nguyennhutkhanhtom/NPU/docs/demos/README.md

# Demos

> **Category: GUIDE.** Choose the execution flow before running a model.

| Demo | Purpose |
|---|---|
| [NanoFable language](language.md) | Run pretrained autonomous inference on `llm_soc` |
| [Supported model/exporter](candidates.md) | Check compatibility and requirements for changing checkpoints |
| [Legacy demos](legacy/README.md) | MNIST, CPU/RTL hybrid NanoFable and old model surveys |

Current verification and application status: [optimization status](../verification/optimization_status.md).
