nguyennhutkhanhtom/NPU/tools/README.md

# Công cụ hỗ trợ

> **Category: GUIDE.**

[Project](../README.md) → **Tools**

| Thư mục | Công việc |
|---|---|
| [timing](timing/README.md) | Chạy Quartus, extract reports và ghi timing evidence |
| [optimization](optimization/README.md) | Archive checkpoint và tính tỷ lệ thay đổi RTL |
| [llm](llm/README.md) | Generate/kiểm tra bảng số học của graph |
| [docs](docs/README.md) | Công cụ source guide và render tài liệu/sơ đồ |

Sơ đồ đang giữ snapshot cũ; đợt cập nhật docs 06/10/2026 chưa chạy render hoặc
sửa diagram definitions. Chỉ chạy công cụ tương ứng với phần cần thay đổi và
giữ evidence/archive trước khi tạo output mới.
