nguyennhutkhanhtom/NPU/docs/reviews/README.md

# Implementation reviews

> **Category: GUIDE.** Reviews explain decisions at a named source snapshot; they do not define live status.

| Review | Scope |
|---|---|
| [P0/P1 implementation evidence](../../review/architecture_optimization_20261007.md) | Latest implemented greedy bypass and bounded linear-row overlap rationale |
| [Architecture proposal review](../../review/architecture_review.md) | Assessment and measurement order for the preceding proposal |
| [Throughput review v3](rtl_change_review_v3.md) | Earlier cache/streaming/engine implementation rationale, snapshot 2026-10-06 |
| [Archived reviews](../history/reviews/rtl_change_review_v2.md) | Earlier timing, integration and design reviews; see [history index](../history/README.md) |

Current verification and implementation status: [optimization status](../verification/optimization_status.md).
