nguyennhutkhanhtom/NPU/docs/design/exact_throughput_optimization.md

# Tối ưu throughput và quyền dùng tài nguyên

> **Category: GUIDE.**

[Tài liệu](../README.md) → [Thiết kế](README.md) → **Throughput**

Tối ưu giữ geometry cố định của graph: bốn layer, 128 channel, bốn head,
FFN 384 channel, vocabulary 4.096 và context 128. Mục tiêu là giảm compute clocks
và SRAM transactions, đồng thời giữ rounding, saturation, faults, sampling ties
và thứ tự cập nhật PRNG. Số liệu đo nằm trong [review version 3](../reviews/rtl_change_review_v3.md).

## Quyền sở hữu tài nguyên

| Owner | Công việc | Tài nguyên dùng chung |
|---|---|---|
| llm_soc | Graph, metadata, operand cache, scaling, vector writes, probability/V pass và sampling | SRAM, SIMD và các scalar units |
| llm_linear_engine | Một ternary row, hai-word prefetch credit, reserved-code fault và response drain | Parameter SRAM, immutable operand cache |
| llm_head_engine | Stream 4.096 row: scale word mỗi tám row, bốn int8 chunk mỗi row, tối đa tám read outstanding, S39 row accumulation theo thứ tự | Parameter SRAM, cached final hidden vector và SIMD |
| llm_attention_engine | Q/K causal requests, score scaling, score storage và maximum | KV SRAM, held query và SIMD |
| llm_attention_normalize | Exact RNE divide, sign restoration và S24 clamp theo batch | Lane 0 dùng chung divider RMSNorm; ba divider riêng bổ sung |
| ternary_dot32 | S25 terms và balanced S30 reduction pipeline | Logic add/subtract riêng |

Mỗi pass phải drain các response trước khi parent chuyển resource ownership.
Parameter SRAM chỉ có một owner phát request tại một thời điểm. Các test kiểm
tra ownership và giới hạn hai-word prefetch của linear engine.

## Operand cache, scales và packed stores

Một register cache **12 × 768 bit = 9.216 payload bits** dùng chung cho linear
và head. Q, O, Gate và Down preload input; Q/K/V và Gate/Up chỉ reuse khi source,
geometry và family khớp. Producer writes, reset, launch, faults hoặc head entry
làm mất hiệu lực linear cache. Head nạp lại bốn row của final-normalized vector
ở mỗi pass; không thêm cache riêng cho head.

Head engine giữ hai scale slot, mỗi slot là tám coefficient U24 của một nhóm
tám vocabulary row; bit [31:24] của mỗi slot 32 bit bị bỏ qua. Scale word của
nhóm G chỉ ghi đè slot của nhóm G-2 sau 32 weight response của nhóm G-1, khi
nhóm G-2 đã retire. Vocabulary order và PRNG updates giữ nguyên. RoPE K
reuse bảng của Q khi position tag còn hợp lệ, đồng thời vẫn đọc K vector riêng.
Nạp norm gains vào table storage dùng chung làm mất validity của RoPE tag.

Linear pack 32 scalar outputs vào write_vector_q. Lane 31 được capture trước
transaction full-mask kế tiếp; completion chờ write drain. Reset probes phủ
prefetch, in-flight dot, coefficient processing và lane cuối trước flush.

## SIMD streaming và replication

llm_math giữ mode legacy mặc định. Với STREAMING=1, `start && in_ready` có thể
accept mỗi clock khi pipeline còn các transaction trước. Tính từ acceptance E0,
product_valid xuất ở E3, sum_valid ở E8 và legacy done ở E9. Các response có stage
riêng; consumer phải dùng đúng valid channel. Reset hủy validity và deassert ready.

Bốn sigmoid lane xử lý batch bốn phần tử với interpolation/RNE giữ nguyên.
Normalizer capture quotient và rounding metadata, rồi tách round, phục hồi dấu
và clamp thành các stage register.

ATTN_DIV_LANES và SIGMOID_LANES là elaboration parameters, hỗ trợ các lũy thừa
hai chia hết 32: 1, 2, 4, 8, 16 hoặc 32. Geometry mặc định và phạm vi áp dụng của
evidence được ghi tại [kiến trúc](full_rtl_language.md) và [trạng thái](../verification/optimization_status.md).

## Transaction geometry

Việc reuse operand/scale có giới hạn và ghi vector dạng packed giúp giảm số
SRAM transaction. Số liệu đo trước/sau thuộc [throughput review ngày 2026-10-06](../reviews/rtl_change_review_v3.md);
số liệu hiện tại và phạm vi áp dụng được ghi trong [trạng thái kiểm chứng](../verification/optimization_status.md).

## Source và kiểm chứng

isqrt_u64 và sram_word_tile đã tách thành file dùng chung. Full-top Quartus file
list không compile norm, banked_word_ram hoặc sram_256_wrapper legacy. Những
module này vẫn được giữ cho caller và regression riêng. Operator IDs cần cho
fixture cũ được giữ; chúng không thêm một graph operation mới.

Regression giữ reference S128 độc lập, kiểm tra sustained/sparse streaming,
S24_MIN, reserved ternary code và normalization exact. Không dùng approximate
reciprocal trong đường normalize này. [Verification status](../verification/optimization_status.md)
ghi bằng chứng áp dụng cho workspace; application cần all-seven PASS và full-top
timing khớp source/config trước pretrained execution.

## Cache reuse và ownership

Sơ đồ này tóm tắt các điều kiện điều khiển của parent; nó không bổ sung cache
module instance. Các predicate trong source vẫn là nguồn chuẩn.

```mermaid
%%{init: {
  "theme": "base",
  "themeVariables": {
    "background": "#ffffff",
    "primaryTextColor": "#111111",
    "secondaryTextColor": "#111111",
    "tertiaryTextColor": "#111111",
    "lineColor": "#444444",
    "clusterBkg": "#ffffff",
    "clusterBorder": "#aaaaaa",
    "edgeLabelBackground": "#ffffff",
    "fontSize": "17px"
  },
  "flowchart": {
    "curve": "linear",
    "nodeSpacing": 30,
    "rankSpacing": 40,
    "htmlLabels": true,
    "useMaxWidth": true
  }
}}%%
flowchart TB
 S["Parent input selection<br/>Source, shape and<br/>family"] --> T{"Matching valid tag?"}
 T -->|"Q/K/V or Gate/Up reuse"| C["Operand cache<br/>12 × 768 bit"]
 T -->|"miss or head entry"| L["Vector SRAM refill"]
 L --> C
 C --> A["Linear / head<br/>operands Parent-owned routing"]
 P["Producer / reset /<br/>launch / fault Invalidate<br/>per parent predicates"] -.-> T
classDef control fill:#f8cecc,stroke:#b85450,color:#111111;
classDef interface fill:#fff2cc,stroke:#d6b656,color:#111111;
classDef buffer fill:#f5f5f5,stroke:#666666,color:#111111;
classDef compute fill:#b1ddf0,stroke:#10739e,color:#111111;
classDef output fill:#dae8fc,stroke:#6c8ebf,color:#111111;
classDef platform fill:#e1d5e7,stroke:#9673a6,color:#111111;
class T control;
class S,C,A,P buffer;
class L platform;
```

```mermaid
%%{init: {
  "theme": "base",
  "themeVariables": {
    "background": "#ffffff",
    "primaryTextColor": "#111111",
    "secondaryTextColor": "#111111",
    "tertiaryTextColor": "#111111",
    "lineColor": "#444444",
    "clusterBkg": "#ffffff",
    "clusterBorder": "#aaaaaa",
    "edgeLabelBackground": "#ffffff",
    "fontSize": "17px"
  },
  "flowchart": {
    "curve": "linear",
    "nodeSpacing": 30,
    "rankSpacing": 40,
    "htmlLabels": true,
    "useMaxWidth": true
  }
}}%%
flowchart LR
 R["RoPE position tag"] --> K{"Matching valid table?"}
 K -->|"yes"| U["Reuse cos /<br/>sin Read K<br/>vector separately"]
 K -->|"no"| F["Fetch table<br/>Update tag"]
 G["Norm gain load<br/>Shared payload invalidation"] -.-> K
classDef control fill:#f8cecc,stroke:#b85450,color:#111111;
classDef interface fill:#fff2cc,stroke:#d6b656,color:#111111;
classDef buffer fill:#f5f5f5,stroke:#666666,color:#111111;
classDef compute fill:#b1ddf0,stroke:#10739e,color:#111111;
classDef output fill:#dae8fc,stroke:#6c8ebf,color:#111111;
classDef platform fill:#e1d5e7,stroke:#9673a6,color:#111111;
class K control;
class R,U,F,G buffer;
```
