nguyennhutkhanhtom/NPU/docs/design/host_interface.md

# Host interface của llm_soc

> **Category: GUIDE.**

[Tài liệu](../README.md) → [Thiết kế](README.md) → **Host interface**

Host và DUT dùng cùng `clk`. Mọi địa chỉ bên dưới là byte address, căn chỉnh
4 byte. Core matmulfree có host contract riêng trong [interface legacy](<legacy/interfaces.md>).

## Ports

| Signal | Vai trò |
|---|---|
| clk, rst_n | Clock và reset active-low |
| host_en, host_we | Có request; 1=write, 0=read |
| host_addr, host_wdata | Address và write data, mỗi tín hiệu 32 bit |
| host_ready, host_rdata | ACK và read data 32 bit |
| running, ready | Graph đang chạy hoặc idle, xuất qua register |
| error, overflow_out | Lỗi graph/format/bounds; cờ một kết quả linear bị kẹp S24 |
| pc_debug, instr_debug | Position 9 bit và phase/debug word 13 bit |

## Memory map

| Window/register | Address | Nội dung |
|---|---|---|
| Parameters | 0x00000000…0x000BFFFC | 768 KiB, 32-bit host lanes của word 256 bit |
| Prompt IDs | 0x00100000…0x001001FC | 128 slot; lấy 12 bit thấp của word |
| Output IDs | 0x00200000…0x002001FC | Continuation IDs; đọc khi graph idle |
| Status | 0x00400000 | Running, ready, error, overflow và output count |
| Prompt count | 0x00400004 | Số prompt token, ghi 8 bit thấp; mặc định 0 |
| Maximum new tokens | 0x00400008 | Số token mới tối đa; mặc định 96 |
| Start | 0x0040000C | Ghi bit 0=1 khi idle |
| Temperature | 0x00400010 | U8/F8, mặc định 166; 0 chọn greedy |
| Random seed | 0x00400014 | Xorshift32 seed; 0 được đổi thành 1 |
| Minimum new tokens | 0x00400018 | Mask EOS trước count này; mặc định 64 |

Status dùng bits 0=running, 1=ready, 2=error, 3=overflow và bits 11:4=output
count. Overflow chỉ bật khi một hàng kết quả linear (Q/K/V/O/Gate/Up/Down)
bị kẹp về S24, và giữ tới lần START hợp lệ kế tiếp. Các phép kẹp khác
(embedding, RMSNorm, RoPE, cộng dư, SiLU, GMUL, attention, logit) không bật cờ;
với checkpoint pretrained hiện có, không phép kẹp activation nào bão hòa
([census](../../tests/full_rtl/evidence/clamp_census_20261024/results.json)). Chỉ đọc các register/window mà RTL hỗ trợ; không giả định config writes
có register readback. Graph sở hữu KV và vector workspace.

## Một transaction

```mermaid
%%{init: {
  "theme": "base",
  "themeVariables": {
    "background": "#ffffff",
    "primaryTextColor": "#111111",
    "secondaryTextColor": "#111111",
    "tertiaryTextColor": "#111111",
    "lineColor": "#444444",
    "clusterBkg": "#ffffff",
    "clusterBorder": "#aaaaaa",
    "edgeLabelBackground": "#ffffff",
    "fontSize": "17px"
  },
  "flowchart": {
    "curve": "linear",
    "nodeSpacing": 30,
    "rankSpacing": 40,
    "htmlLabels": true,
    "useMaxWidth": true
  }
}}%%
flowchart TB
 I["H_IDLE: host_en captures<br/>address / data<br/>/ write flag"] --> E["H_EXEC: decode registered request"]
 E -->|"Parameter read while idle"| R["H_READ: issue host_read_req"]
 R --> W["H_WAIT: wait for p_host_valid"]
 E -->|"Parameter write while idle"| W
 E -->|"Register / status / output / ignored access"| D["H_DONE: hold host_ready<br/>until host_en drops"]
 W -->|"Read payload captured or write committed"| D
 D -->|"host_en=0 for at least one clock"| I
 C["host_en=0 cancels frontend response<br/>Accepted writes can still commit"] -.-> I
 X["rst_n assertion cancels<br/>uncommitted queue entries<br/>SRAM contents retained"] -.-> I
classDef control fill:#f8cecc,stroke:#b85450,color:#111111;
classDef interface fill:#fff2cc,stroke:#d6b656,color:#111111;
classDef buffer fill:#f5f5f5,stroke:#666666,color:#111111;
classDef compute fill:#b1ddf0,stroke:#10739e,color:#111111;
classDef output fill:#dae8fc,stroke:#6c8ebf,color:#111111;
classDef platform fill:#e1d5e7,stroke:#9673a6,color:#111111;
class C interface;
class E,R,W,D buffer;
class I compute;
class X platform;
```

1. Đặt address, write flag và data; assert `host_en`.
2. Giữ các signal request ổn định cho đến khi `host_ready=1`.
3. Với read, lấy `host_rdata` tại ACK.
4. Deassert `host_en` ít nhất một clock rồi bắt đầu request kế tiếp.

Parameters được đọc đồng bộ qua adapter. Write ACK chờ leaf commit; thời gian
ACK có thể khác nhau giữa memory access và register access. Write trong lúc graph
đang chạy không sửa parameters/config/prompt. Status vẫn dùng để poll tiến độ.
Sau một lỗi (fault), status giữ running=1 cho đến khi phần việc engine/memory
đang dở đã drain xong; START ghi trong lúc đó bị bỏ qua như mọi write khi đang chạy.

Deassert enable trước execution edge sẽ hủy write. Sau khi write được accept,
deassert enable sẽ hủy response nhưng write vẫn có thể commit. Reset hủy queue
entry chưa commit và giữ các word đã commit; host không được giả định rollback.

## Trình tự chạy graph

1. Reset và chờ internal reset release sau hai rising edge.
2. Khi idle, ghi đầy đủ parameter image qua parameter window.
3. Ghi prompt IDs theo thứ tự, bắt đầu tại 0x00100000.
4. Ghi prompt count, maximum new tokens, temperature, seed và minimum new tokens.
5. Ghi START; polling status đến khi graph idle, kiểm tra error và output count.
6. Đọc continuation IDs từ output window rồi decode bằng tokenizer đã pin.

Điều kiện launch: prompt count >0, maximum new tokens >0 và tổng của chúng ≤128.
Exporter giới hạn new tokens trong 1…127 và kiểm tra tokenized prompt trước khi
mô phỏng. Chọn `MinNew ≤ NewTokens` trong demo để cấu hình EOS dễ hiểu.

Testbench application đã thực hiện host sequence này. Dùng
[hướng dẫn NanoFable](../demos/language.md) để chạy từ PowerShell thay vì tự ghi bus.
[Protocol và cancellation evidence](../verification/optimization_status.md) ghi
các trường hợp handshake, reset và ACK đã kiểm chứng.
