nguyennhutkhanhtom/NPU/docs/demos/legacy/README.md

# Demo và khảo sát legacy

> **Category: LEGACY.**

[Tài liệu](../../README.md) → [Demo](../README.md) → **Legacy**

| Tài liệu | Phạm vi |
|---|---|
| [NanoFable hybrid](nanofable_hybrid.md) | CPU generation, 168 lượt linear RTL và 33.792 output S32 |
| [Binary-MNIST160](<mnist.md>) | Checkpoint classifier và core matmulfree trên 10 ảnh mẫu |
| [Khảo sát model 32 PE](model_candidates.md) | Các model/layout cho parameter 32 KiB và workspace 8 KiB |

Các kết quả ở đây giữ giá trị trong phạm vi của từng báo cáo. Hướng dẫn chạy
full graph hiện tại ở [NanoFable trên llm_soc](../language.md); trạng thái
application ở [verification status](../../verification/optimization_status.md).
