nguyennhutkhanhtom/NPU/docs/source_guide/blocks/llm_gumbel_lut.svh.md

# llm_gumbel_lut.svh

> **Role:** Combinational S24/F16 samples of -ln(-ln((index+0.5)/256)).
> **Scope:** CURRENT. **Category:** GUIDE.
> **Source:** [llm_gumbel_lut.svh](<../../../Verilog Source code/llm_gumbel_lut.svh>).

## Important contracts

`llm_gumbel_sample` takes an 8-bit index covering 0…255. The parent owns PRNG progression, temperature scaling and score saturation. The explicit case table has no register or memory latency. Numeric entries are generated by [table generator](../../../tools/llm/generate_tables.py); the source table owns exact values.

## Related docs

[Numeric contracts](../../design/full_rtl_language.md#hợp-đồng-số-học) · [RTL math tests](../../../tests/full_rtl/tb_math.sv) · [Source index](README.md)
