nguyennhutkhanhtom/NPU/docs/source_guide/full_graph.md

# Các khối RTL của full graph

> **Category: GUIDE.**

[Tài liệu](../README.md) → [Source guide](README.md) → **Full graph**

## Top và cấu hình

File chính là [llm_soc.sv](<../../Verilog Source code/llm_soc.sv>).
Nó quản lý host, graph và tài nguyên dùng chung. [matmulfree.sv](<../../Verilog Source code/matmulfree.sv>)
là top legacy, dùng ISA/descriptor và memory map khác.

`llm_soc` có 32 SIMD lane, mỗi lane tạo một term của dot product; reduction tạo
một output. Số lane không đồng nghĩa với 32 output hoàn chỉnh cùng lúc. Bốn
sigmoid lane và bốn divider lane mặc định tăng throughput cho các batch tương ứng.

## Sơ đồ tài nguyên và đường dữ liệu

Đây là functional overview. Các đường qua **Parent request and operand muxes**
được thực hiện trong llm_soc, không phải dây nối trực tiếp giữa hai engine. Xem
[hierarchy và port-map manifest](../diagrams/README.md) để tra instance, generate
scope và kết nối chính xác.

```mermaid
%%{init: {
  "theme": "base",
  "themeVariables": {
    "background": "#ffffff",
    "primaryTextColor": "#111111",
    "secondaryTextColor": "#111111",
    "tertiaryTextColor": "#111111",
    "lineColor": "#444444",
    "clusterBkg": "#ffffff",
    "clusterBorder": "#aaaaaa",
    "edgeLabelBackground": "#ffffff",
    "fontSize": "17px"
  },
  "flowchart": {
    "curve": "linear",
    "nodeSpacing": 30,
    "rankSpacing": 40,
    "htmlLabels": true,
    "useMaxWidth": true
  }
}}%%
flowchart TB
 H["Host interface<br/>32-bit request / response"] <--> F["Host frontend<br/>Prompt, config and output IDs"]
 subgraph MEMORY["Shared storage"]
  P["u_parameters<br/>24576 × 256 bit"]
  V["u_vectors<br/>96 × 768 bit"]
  K["u_cache<br/>4096 × 768 bit"]
 end
 F <--> P
 R["Parent resource muxes<br/>Compute requests / payloads"] <--> P
 R <--> V
 R <--> K
 C["Graph / operator control<br/>Phase and routing"] -.-> R
 C -.-> F
classDef control fill:#f8cecc,stroke:#b85450,color:#111111;
classDef interface fill:#fff2cc,stroke:#d6b656,color:#111111;
classDef buffer fill:#f5f5f5,stroke:#666666,color:#111111;
classDef compute fill:#b1ddf0,stroke:#10739e,color:#111111;
classDef output fill:#dae8fc,stroke:#6c8ebf,color:#111111;
classDef platform fill:#e1d5e7,stroke:#9673a6,color:#111111;
class C control;
class H interface;
class R buffer;
class F output;
class P,V,K platform;
style MEMORY fill:#ffffff,stroke:#aaaaaa,color:#111111;
```

```mermaid
%%{init: {
  "theme": "base",
  "themeVariables": {
    "background": "#ffffff",
    "primaryTextColor": "#111111",
    "secondaryTextColor": "#111111",
    "tertiaryTextColor": "#111111",
    "lineColor": "#444444",
    "clusterBkg": "#ffffff",
    "clusterBorder": "#aaaaaa",
    "edgeLabelBackground": "#ffffff",
    "fontSize": "17px"
  },
  "flowchart": {
    "curve": "linear",
    "nodeSpacing": 30,
    "rankSpacing": 40,
    "htmlLabels": true,
    "useMaxWidth": true
  }
}}%%
flowchart TB
 C["Parent phase control<br/>llm_soc"] -.-> L & H & A
 subgraph ENGINES["Compute engines"]
 L["u_linear_engine<br/>Ternary rows"]
 H["u_head_engine<br/>Ordered int8 chunks"]
 A["u_attention_engine<br/>Causal QK scores"]
 end
 R["Parent muxes<br/>Requests / operands / returns"] <--> L & H & A
 R --> M["u_math<br/>32 streaming SIMD lanes"]
 M -->|"sum / valid"| R
 style ENGINES fill:#ffffff,stroke:#aaaaaa,color:#111111;
classDef control fill:#f8cecc,stroke:#b85450,color:#111111;
classDef interface fill:#fff2cc,stroke:#d6b656,color:#111111;
classDef buffer fill:#f5f5f5,stroke:#666666,color:#111111;
classDef compute fill:#b1ddf0,stroke:#10739e,color:#111111;
classDef output fill:#dae8fc,stroke:#6c8ebf,color:#111111;
classDef platform fill:#e1d5e7,stroke:#9673a6,color:#111111;
class C control;
class L,H,A,M compute;
class R interface;
```

```mermaid
%%{init: {
  "theme": "base",
  "themeVariables": {
    "background": "#ffffff",
    "primaryTextColor": "#111111",
    "secondaryTextColor": "#111111",
    "tertiaryTextColor": "#111111",
    "lineColor": "#444444",
    "clusterBkg": "#ffffff",
    "clusterBorder": "#aaaaaa",
    "edgeLabelBackground": "#ffffff",
    "fontSize": "17px"
  },
  "flowchart": {
    "curve": "linear",
    "nodeSpacing": 30,
    "rankSpacing": 40,
    "htmlLabels": true,
    "useMaxWidth": true
  }
}}%%
flowchart TB
 C["Parent arithmetic routing<br/>RMSNorm / attention / SiLU"] -.-> D & Q & N
 D["u_div<br/>Shared divider"] -->|"quotient + remainder"| N["u_attention_normalize<br/>Shared lane 0 + private lanes"]
 Q["Root / sigmoid resources"] --> C
 N --> C
classDef control fill:#f8cecc,stroke:#b85450,color:#111111;
classDef interface fill:#fff2cc,stroke:#d6b656,color:#111111;
classDef buffer fill:#f5f5f5,stroke:#666666,color:#111111;
classDef compute fill:#b1ddf0,stroke:#10739e,color:#111111;
classDef output fill:#dae8fc,stroke:#6c8ebf,color:#111111;
classDef platform fill:#e1d5e7,stroke:#9673a6,color:#111111;
class C interface;
class D,Q platform;
class N output;
```

## Đọc source theo luồng

| Thứ tự | Source | Nên tìm gì? |
|---|---|---|
| 1 | [llm_pkg](<../../Verilog Source code/llm_pkg.sv>) | Constants, layout và helper nhỏ |
| 2 | [llm_soc](<../../Verilog Source code/llm_soc.sv>) | Host FSM, graph FSM, operator states và register owners |
| 3 | [linear engine](<../../Verilog Source code/llm_linear_engine.sv>) | Prefetch, operand chunk, reduction và format fault |
| 4 | [attention engine](<../../Verilog Source code/llm_attention_engine.sv>) | Causal requests, Q/K score pipeline và score memory |
| 5 | [attention normalizer](<../../Verilog Source code/llm_attention_normalize.sv>) | Quotient/remainder, RNE, dấu và clamp |
| 6 | [head engine](<../../Verilog Source code/llm_head_engine.sv>) | Vocabulary row, ordered chunks và shared SIMD |
| 7 | [memory adapters](<../../Verilog Source code/llm_parameter_ram.sv>) | Accepted requests, response-valid, write commitment |

## Control và các engine

| Module | Input/output hoặc state cần theo dõi |
|---|---|
| llm_soc | graph, op, layer_q, position_q, generated_q, error, overflow_out và host FSM |
| llm_linear_engine | Hai-word FIFO, credits, chunk index, operand capture, accumulator, fault và response drain |
| llm_head_engine | Stream 4.096 vocabulary row: scale word mỗi tám row, bốn weight chunk mỗi row, tối đa tám read outstanding, hai scale slot và S39 accumulator theo thứ tự |
| llm_attention_engine | position bound, KV request tags, sum_valid, score pipeline và maximum |
| llm_attention_normalize | Batch/lane progress, shared divider lane zero, rounding metadata và result-valid |

Parent có thể overlap một next linear row với scalar/store tail hiện tại; completion
được giữ lại để bảo đảm thứ tự tiêu thụ.

Graph chọn một phase tại một thời điểm. Engine có thể giữ nhiều request hoặc
arithmetic transaction trong pipeline của phase đó. Parent chỉ đổi quyền dùng
tài nguyên sau khi các response của pass đã được drain.

`llm_soc` giữ một operand cache 12 × 768 bit. Q/K/V và Gate/Up chỉ reuse khi
source, shape và family hợp lệ; head reload input khi vào pass. Head engine giữ
scale word của hai nhóm tám vocabulary row; parent giữ table RoPE có position tag. Các điều kiện
invalidate ở [hợp đồng cache](../design/exact_throughput_optimization.md).

## Số học chung

| Module | Hợp đồng |
|---|---|
| [ternary_dot32](<../../Verilog Source code/ternary_dot32.sv>) | Mã 00/01/11 → zero/positive/negative; term mở rộng S25, reduction S30; code 10 gây fault |
| [llm_math](<../../Verilog Source code/llm_math.sv>) | STREAMING=1 accept theo start && in_ready; product E3, sum E8, done E9 tính từ E0 |
| [logic_mul](<../../Verilog Source code/logic_mul.sv>) | Cây nhân bằng bit products và cộng; không runtime multiplication operator |
| [div](<../../Verilog Source code/div.sv>) | Unsigned divide bằng shift/subtract; caller xử lý rounding/sign |
| [isqrt_u64](<../../Verilog Source code/isqrt_u64.sv>) | Integer square root dùng chung; file đã tách khỏi norm legacy |
| [sigmoid](<../../Verilog Source code/sigmoid.sv>) | ROM/interpolation; các lane dùng cùng quy tắc số học |

Tín hiệu product_valid, sum_valid và done thuộc các stage khác nhau. Không dùng
product của một transaction với sum của transaction khác. Reset hủy validity;
payload register không reset vẫn phải được bảo vệ bởi protocol hợp lệ.

## Memory và reset

| Module | Vai trò |
|---|---|
| [llm_parameter_ram](<../../Verilog Source code/llm_parameter_ram.sv>) | Parameter window, host lane selection và ACK sau commit |
| [llm_bank_ram](<../../Verilog Source code/llm_bank_ram.sv>) | Các bank S24 của vectors/KV; lane mask và wr_busy |
| [pipelined_word_ram](<../../Verilog Source code/pipelined_word_ram.sv>) | Tiled request/response adapter |
| [quartus_word_ram](<../../Verilog Source code/quartus_word_ram.sv>) | Technology leaf duy nhất chứa altsyncram |
| [sram_word_tile](<../../Verilog Source code/sram_word_tile.sv>) | Portable behavioral leaf |
| [reset_release](<../../Verilog Source code/reset_release.sv>) | Assert reset ngay; nhả sau hai rising edge |

[Host interface](../design/host_interface.md) ghi cách software điều khiển top.
[SRAM binding](../design/asic_memory_binding.md) ghi latency/collision/reset cần
bảo toàn khi thay technology leaf.

## Chú giải và sơ đồ đã lưu

Mỗi module có một tài liệu trong [modules/](README.md#danh-mục-file-rtl);
[mục lục source guide](README.md) liệt kê đủ 41 file RTL/LUT. [Hierarchy legacy](<legacy/README.md>)
lưu sơ đồ matmulfree.
