nguyennhutkhanhtom/NPU/docs/source_guide/modules/npu_pkg.md

# `npu_pkg` — Package hằng số, kiểu và hàm làm tròn / bão hòa dùng chung

| Mục | Giá trị |
|---|---|
| File | `npu_pkg.sv` |
| Loại | `package` (không phải phần cứng độc lập) |
| Nhóm | Hạ tầng — dùng chung |
| Được dùng bởi | **`llm_soc`**: `llm_soc`, `llm_attention_engine`, `sigmoid` (dùng `rne_shift64`, `sat_s16`, `sat_s32`). **Legacy**: `matmulfree`, `descriptor_file`, `rowwise_dispatch`, `rowwise_op`, `norm_dispatch`, `norm`, `ternary_mul`, `postscale`, `mul` |

## 0. Kiến thức cần biết trước

**Package.** Trong SystemVerilog, `package` là nơi gom các hằng số, kiểu dữ liệu và hàm dùng chung, tương tự file header trong C. Module dùng nó bằng `import npu_pkg::*;`.

**Hàm trong phần cứng.** Một `function` trong RTL không phải chương trình con được "gọi" lúc chạy. Mỗi chỗ dùng hàm sinh ra **một bản mạch riêng**. Vì vậy các hàm ở đây đều nhỏ và thuần tổ hợp.

**`struct packed`.** Một nhóm trường bit ghép liền nhau thành một vector bit dài. Ví dụ `ws_desc_t` dài đúng 32 bit, nên host ghi được bằng một word.

Các khái niệm bão hòa, RNE, scale dạng m × 2⁻ʳ được giải thích ở tài liệu kiến thức nền, mục 3.

Các khái niệm chung (thanh ghi, cạnh clock, pipeline, valid, fixed-point, RNE…) được giải thích trong [../00_kien_thuc_nen.md](../00_kien_thuc_nen.md).

## 1. Tổng quan

`npu_pkg` gom các quy ước của NPU `matmulfree`: kích thước bộ nhớ, độ rộng dữ liệu, định dạng tensor, cấu trúc descriptor. Ngoài ra nó chứa các hàm làm tròn/bão hòa (`rne_shift64`, `sat_s16`, `sat_s32`) mà **cả `llm_soc`** cũng import và dùng (RNE ở mọi bước `*_ROUND`, `sat_s32` cho logit, `sat_s16` cho đầu vào sigmoid). Các hàm này là **hàm thuần tổ hợp**: mỗi chỗ gọi sinh ra một khối logic riêng.

## 2. Hằng số

| Hằng | Giá trị | Ý nghĩa |
|---|---|---|
| `SRAM_W` | 256 | Bit / hàng SRAM |
| `PARAM_AW`, `PARAM_DEPTH` | 10, 1024 | SRAM tham số 32 KiB (`mem_mapping`) |
| `WORK_AW`, `WORK_DEPTH` | 8, 256 | Workspace 8 KiB (`register`) |
| `ACT_W` | 8 | Activation S8 |
| `STATE_W` | 16 | Trạng thái S16 |
| `WEIGHT_W` | 2 | Trọng số ternary 2 bit |
| `DOT_LANES` | 32 | Số làn tích vô hướng |
| `VEC_LANES` | 2 | Số làn vector |
| `ACC_W` | 18 | Bộ tích lũy |
| `K_MAX` | 512 | Độ dài tối đa của vector/K |
| `M_W`, `SHIFT_W` | 24, 6 | Mantissa và số bit dịch của scale |

## 3. Kiểu

```mermaid
flowchart LR
    classDef ctrl fill:#f8cecc,stroke:#b85450,color:#000
    classDef param fill:#f5f5f5,stroke:#666666,color:#333
    WS["ws_desc_t (32b)<br/>base_word 8 · length 10 · fmt 2<br/>frac_bits 5 · reserved 7"]:::ctrl
    MD["mat_desc_t (96b)<br/>weight_base 10 · bias_base 10 · k_len 10 · n_rows 10<br/>scale_m 24 · scale_r 6 · output_s32 1 · reserved 25"]:::param
    FMT["tensor_fmt_t<br/>S8=0 · S16=1 · U16=2 · S32=3"]:::ctrl
    FMT --> WS
```

Chi tiết từng trường xem [descriptor_file.md](descriptor_file.md).

## 4. Hàm

| Hàm | Chức năng |
|---|---|
| `sat_s16(x)` / `sat_s32(x)` | Bão hòa số S64 về S16 / S32 |
| `rne_shift64(x, shift)` | Dịch phải số học, làm tròn tới chẵn gần nhất (RNE), shift 0..63 |
| `rne_shift42(x, shift)` | RNE cho tích S42 của postscale; `shift ≥ 42` trả 0 |
| `scale_shift64(x, shift)` | `shift ≥ 0`: `rne_shift64`; `shift < 0`: dịch trái |
| `ws_words(d)` | Số word 256 bit mà tensor chiếm: S8 `ceil(n/32)`, S16/U16 `ceil(n/16)`, S32 `ceil(n/8)` |
| `ws_valid(d)` | `0 < length ≤ 512`, `frac_bits ≤ 24`, `base_word + ws_words ≤ 256` |
| `ranges_overlap(a, an, b, bn)` | Hai vùng `[a, a+an)` và `[b, b+bn)` có giao nhau không |

### 4.1 Làm tròn RNE không cần phủ định

`rne_shift64` không tính giá trị tuyệt đối. Nó dùng tính chất của dịch số học:

1. `q = x >>> shift` cho `floor(x / 2^shift)`.
2. Các bit bị bỏ được dồn lên MSB: `discarded = x << (64 − shift)`. Biểu thức dịch dùng 7 bit, nên khi `shift = 0` lượng dịch là 64 và mọi bit bị đẩy ra; không có bit nào bị bỏ.
3. `guard = discarded[63]` (bit nửa), `sticky = |discarded[62:0]`.
4. `inc = guard && (sticky || q[0])`, và kết quả là `q + inc`.

Vì `floor` đúng cho cả số âm, phần dư luôn dương, nên một quy tắc duy nhất làm tròn đúng cả hai dấu, kể cả trường hợp hòa: chọn số chẵn.
