nguyennhutkhanhtom/NPU/docs/source_guide/blocks/banked_word_ram.sv.md

# banked_word_ram.sv

> **Category: GUIDE. Scope: LEGACY.** RTL is authoritative; diagrams use the [shared visual style](../../diagrams/diagram_style.md).
[Documentation](../../README.md) → [Source guide](../full_graph.md) → [RTL index](README.md)

**Source:** [banked_word_ram.sv](<../../../Verilog%20Source%20code/banked_word_ram.sv>).

## At a glance

| Item | Description |
|---|---|
| Responsibility | Legacy three-pass RMS normalization and quantization. Two shared structural multipliers, one divider and the separately defined isqrt_u64 serve the explicit pass controller. Workspace scratch and final quantized values are packed in 256-bit words. |

## Sơ đồ kiến trúc

```mermaid
%%{init: {
  "theme": "base",
  "themeVariables": {
    "background": "#ffffff",
    "primaryTextColor": "#111111",
    "secondaryTextColor": "#111111",
    "tertiaryTextColor": "#111111",
    "lineColor": "#444444",
    "clusterBkg": "#ffffff",
    "clusterBorder": "#aaaaaa",
    "edgeLabelBackground": "#ffffff",
    "fontSize": "17px"
  },
  "flowchart": {
    "curve": "linear",
    "nodeSpacing": 30,
    "rankSpacing": 40,
    "htmlLabels": true,
    "useMaxWidth": true
  }
}}%%
flowchart TB
    REQ["Read and write requests"] --> TILE["1024-word leaf SRAM"]
    REQ --> TAG["Registered tile selection"]
    TILE --> MUX["One-hot data reduction"]
    TAG --> MUX
    MUX --> OUT["Read data after one edge"]
classDef control fill:#f8cecc,stroke:#b85450,color:#111111;
classDef interface fill:#fff2cc,stroke:#d6b656,color:#111111;
classDef buffer fill:#f5f5f5,stroke:#666666,color:#111111;
classDef compute fill:#b1ddf0,stroke:#10739e,color:#111111;
classDef output fill:#dae8fc,stroke:#6c8ebf,color:#111111;
classDef platform fill:#e1d5e7,stroke:#9673a6,color:#111111;
class REQ interface;
class TILE platform;
class TAG,OUT buffer;
class MUX compute;
```
