nguyennhutkhanhtom/NPU/docs/source_guide/blocks/isqrt_u64.sv.md

# isqrt_u64.sv

> **Category: GUIDE. Scope: CURRENT (may also have legacy callers).** RTL is authoritative; diagrams use the [shared visual style](../../diagrams/diagram_style.md).
[Documentation](../../README.md) → [Source guide](../full_graph.md) → [RTL index](README.md)

**Source:** [isqrt_u64.sv](<../../../Verilog%20Source%20code/isqrt_u64.sv>).

## At a glance

| Item | Description |
|---|---|
| Responsibility | Unsigned floor square root with 32 radix-four iterations. Append two radicand bits per step; one U35 subtractor supplies the trial remainder and borrow decision. Root and remainder feedback are explicit registers. start is accepted only when idle; busy/done frame the result. |

## Sơ đồ kiến trúc

```mermaid
%%{init: {
  "theme": "base",
  "themeVariables": {
    "background": "#ffffff",
    "primaryTextColor": "#111111",
    "secondaryTextColor": "#111111",
    "tertiaryTextColor": "#111111",
    "lineColor": "#444444",
    "clusterBkg": "#ffffff",
    "clusterBorder": "#aaaaaa",
    "edgeLabelBackground": "#ffffff",
    "fontSize": "17px"
  },
  "flowchart": {
    "curve": "linear",
    "nodeSpacing": 30,
    "rankSpacing": 40,
    "htmlLabels": true,
    "useMaxWidth": true
  }
}}%%
flowchart TB
 I["start / U64 radicand"] --> R["Radicand work register<br/>Shift left by two per step"]
 R --> A["Append next two bits<br/>U34 remainder_shift"]
 M["U34 remainder register"] --> A
 Q["U32 root register"] --> T["Trial: root shifted left two OR 1"]
 A --> S["U35 subtractor<br/>Borrow selects acceptance"]
 T --> S
 S --> M
 S --> Q
 C["Controller / 32-step counter"] -.-> R
 C -.-> Q
 C -.-> M
 Q --> O["root U32 / busy / done"]
classDef control fill:#f8cecc,stroke:#b85450,color:#111111;
classDef interface fill:#fff2cc,stroke:#d6b656,color:#111111;
classDef buffer fill:#f5f5f5,stroke:#666666,color:#111111;
classDef compute fill:#b1ddf0,stroke:#10739e,color:#111111;
classDef output fill:#dae8fc,stroke:#6c8ebf,color:#111111;
classDef platform fill:#e1d5e7,stroke:#9673a6,color:#111111;
class C control;
class I,R,M,Q,O buffer;
class A,T,S compute;
```
