nguyennhutkhanhtom/NPU/docs/source_guide/blocks/llm_parameter_ram.sv.md

# llm_parameter_ram.sv — Parameter SRAM và host commit

> **Category: GUIDE. Scope: CURRENT (may also have legacy callers).** RTL is authoritative; diagrams use the [shared visual style](../../diagrams/diagram_style.md).
[Tài liệu](../../README.md) → [Source guide](../README.md) → [Mục lục](README.md)

**Source:** [llm_parameter_ram.sv](<../../../Verilog%20Source%20code/llm_parameter_ram.sv>).

## At a glance

| Item | Description |
|---|---|
| Responsibility | USE_QUARTUS_MEMORY chọn FPGA IP hoặc model ASIC qua word adapter. Compute read bốn cạnh khi DEPTH≤4096, năm cạnh ở cấu hình24576. Host read thêm một cạnh chọn lane trước frontend ACK. Write ACK chỉ sau leaf commit. Valid/tag pipeline loại response host đã hủy hoặc khác địa chỉ; reset giữ SRAM nhưng hủy queue. |

## Sơ đồ kiến trúc

```mermaid
%%{init: {
  "theme": "base",
  "themeVariables": {
    "background": "#ffffff",
    "primaryTextColor": "#111111",
    "secondaryTextColor": "#111111",
    "tertiaryTextColor": "#111111",
    "lineColor": "#444444",
    "clusterBkg": "#ffffff",
    "clusterBorder": "#aaaaaa",
    "edgeLabelBackground": "#ffffff",
    "fontSize": "17px"
  },
  "flowchart": {
    "curve": "linear",
    "nodeSpacing": 30,
    "rankSpacing": 40,
    "htmlLabels": true,
    "useMaxWidth": true
  }
}}%%
flowchart TB
    HOST["Host active address<br/>and explicit requests"] --> BANK["Eight local lane requests"]
    CORE["Compute row request"] --> BANK
    BANK --> SRAM["Technology-selected word banks"]
    SRAM --> ROW["256-bit row after five edges"]
    ROW --> LANE["Registered host lane selection"]
    TAG["Address owner and<br/>cancellation tags"] --> VALID["Compute and host validity"]
    SRAM --> COMMIT["Write commit acknowledgement"]
classDef control fill:#f8cecc,stroke:#b85450,color:#111111;
classDef interface fill:#fff2cc,stroke:#d6b656,color:#111111;
classDef buffer fill:#f5f5f5,stroke:#666666,color:#111111;
classDef compute fill:#b1ddf0,stroke:#10739e,color:#111111;
classDef output fill:#dae8fc,stroke:#6c8ebf,color:#111111;
classDef platform fill:#e1d5e7,stroke:#9673a6,color:#111111;
class HOST,BANK,CORE,LANE,VALID interface;
class SRAM platform;
class ROW,TAG,COMMIT buffer;
```

## Important state / datapath groups

### [Dòng 1–29: Interface and ownership](<../../../Verilog%20Source%20code/llm_parameter_ram.sv#L1>)

Compute và host truy cập độc quyền do top arbitration. Host data/config không phải intermediate graph.

### [Dòng 30–50: Validity and cancellation](<../../../Verilog%20Source%20code/llm_parameter_ram.sv#L30>)

Host response chỉ hợp lệ khi active, loại read/write và địa chỉ vẫn khớp. ACK write theo wr_valid từ leaf, tránh báo xong trước commit.

### [Dòng 51–60: Tags and host payload](<../../../Verilog%20Source%20code/llm_parameter_ram.sv#L51>)

Địa chỉ/lane đi cùng latency suy ra theo DEPTH; output host register tách tile reduction khỏi pin host_rdata.

### [Dòng 61–95: Local lane banks](<../../../Verilog%20Source%20code/llm_parameter_ram.sv#L61>)

Tám lane U32 có request registers riêng, rồi technology adapter. Nội dung và payload không reset; reset chỉ hủy enables/valid.
