nguyennhutkhanhtom/NPU/docs/source_guide/blocks/logic_mul.sv.md

# logic_mul.sv — Portable bit-product compressor tree

> **Category: GUIDE. Scope: CURRENT (may also have legacy callers).** RTL is authoritative; diagrams use the [shared visual style](../../diagrams/diagram_style.md).
[Tài liệu](../../README.md) → [Source guide](../README.md) → [Mục lục](README.md)

**Source:** [logic_mul.sv](<../../../Verilog%20Source%20code/logic_mul.sv>).

## At a glance

| Item | Description |
|---|---|
| Responsibility | Multiplier tổ hợp từ AND/XOR/OR/NOT, dịch hằng và một bộ cộng cuối. Không dùng toán tử nhân/chia hoặc vendor arithmetic IP. A/B có signedness độc lập; OUT_W lấy modulo 2^OUT_W đúng với cắt độ rộng RTL. Callers giữ nguyên register, valid, reset và latency. Bit dấu B mang trọng số âm bằng complemented row cộng correction một; A được sign/zero extend trước khi dịch. |

## Sơ đồ kiến trúc

```mermaid
%%{init: {
  "theme": "base",
  "themeVariables": {
    "background": "#ffffff",
    "primaryTextColor": "#111111",
    "secondaryTextColor": "#111111",
    "tertiaryTextColor": "#111111",
    "lineColor": "#444444",
    "clusterBkg": "#ffffff",
    "clusterBorder": "#aaaaaa",
    "edgeLabelBackground": "#ffffff",
    "fontSize": "17px"
  },
  "flowchart": {
    "curve": "linear",
    "nodeSpacing": 30,
    "rankSpacing": 40,
    "htmlLabels": true,
    "useMaxWidth": true
  }
}}%%
flowchart TB
    A["Sign or zero extend A"] --> BIT["AND with each<br/>B bit and<br/>constant shift"]
    B["B bits and sign bit"] --> BIT
    BIT --> CSA["XOR sum and<br/>majority carry shifted<br/>left"]
    CSA --> TREE["Compress three rows<br/>into two per<br/>level"]
    TREE --> ADD["One final carry-propagate<br/>adder"]
    ADD --> OUT["Low OUT_W product bits"]
classDef control fill:#f8cecc,stroke:#b85450,color:#111111;
classDef interface fill:#fff2cc,stroke:#d6b656,color:#111111;
classDef buffer fill:#f5f5f5,stroke:#666666,color:#111111;
classDef compute fill:#b1ddf0,stroke:#10739e,color:#111111;
classDef output fill:#dae8fc,stroke:#6c8ebf,color:#111111;
classDef platform fill:#e1d5e7,stroke:#9673a6,color:#111111;
class A,B,TREE buffer;
class BIT,CSA,ADD,OUT compute;
```

## Important state / datapath groups

### [Dòng 1–16: Contract and independent signedness](<../../../Verilog%20Source%20code/logic_mul.sv#L1>)

Payload combinational, không reset/handshake riêng. ASIC map cùng module vào standard cells; không cần technology branch.

### [Dòng 17–35: Elaboration geometry](<../../../Verilog%20Source%20code/logic_mul.sv#L17>)

Đếm rows bằng loop hằng, không tạo divider hay counter runtime. Các genvar tạo hierarchy cố định.

### [Dòng 36–72: Partial products and carry-save compression](<../../../Verilog%20Source%20code/logic_mul.sv#L36>)

Unsigned bits góp A dịch trái; signed top bit góp -A dịch trái. Correction bù cộng một; compressor giữ tổng modulo và không có carry chain ngang mỗi level.

### [Dòng 73–74: Final sum](<../../../Verilog%20Source%20code/logic_mul.sv#L73>)

Hai rows còn lại cộng bằng adder thông thường; OUT_W phải dương. Cắt bit cao có chủ ý, caller chịu trách nhiệm saturation/RNE sau product.
