nguyennhutkhanhtom/NPU/docs/source_guide/blocks/quartus_word_ram.sv.md

# quartus_word_ram.sv — FPGA memory technology binding

> **Category: GUIDE. Scope: CURRENT (may also have legacy callers).** RTL is authoritative; diagrams use the [shared visual style](../../diagrams/diagram_style.md).
[Tài liệu](../../README.md) → [Source guide](../README.md) → [Mục lục](README.md)

**Source:** [quartus_word_ram.sv](<../../../Verilog%20Source%20code/quartus_word_ram.sv>).

## At a glance

| Item | Description |
|---|---|
| Responsibility | IP duy nhất của Quartus trong graph là altsyncram M10K. Một read và một write dùng chung clock, raw read một cạnh; OLD_DATA khi cùng địa chỉ. Storage/output không reset, không khởi tạo. ASIC thay module này phía sau adapter, giữ nguyên interface và contract. |

## Sơ đồ kiến trúc

```mermaid
%%{init: {
  "theme": "base",
  "themeVariables": {
    "background": "#ffffff",
    "primaryTextColor": "#111111",
    "secondaryTextColor": "#111111",
    "tertiaryTextColor": "#111111",
    "lineColor": "#444444",
    "clusterBkg": "#ffffff",
    "clusterBorder": "#aaaaaa",
    "edgeLabelBackground": "#ffffff",
    "fontSize": "17px"
  },
  "flowchart": {
    "curve": "linear",
    "nodeSpacing": 30,
    "rankSpacing": 40,
    "htmlLabels": true,
    "useMaxWidth": true
  }
}}%%
flowchart TB
    WR["Write address data enable"] --> IP["altsyncram M10K 1R 1W"]
    RD["Read address enable"] --> IP
    CLK["Common clock"] --> IP
    IP --> Q["Raw read after one edge"]
    CONTRACT["OLD_DATA and no storage reset"] -.-> IP
classDef control fill:#f8cecc,stroke:#b85450,color:#111111;
classDef interface fill:#fff2cc,stroke:#d6b656,color:#111111;
classDef buffer fill:#f5f5f5,stroke:#666666,color:#111111;
classDef compute fill:#b1ddf0,stroke:#10739e,color:#111111;
classDef output fill:#dae8fc,stroke:#6c8ebf,color:#111111;
classDef platform fill:#e1d5e7,stroke:#9673a6,color:#111111;
class WR,RD interface;
class IP platform;
class CLK,CONTRACT control;
class Q buffer;
```

## Important state / datapath groups

### [Dòng 1–15: Technology boundary and ports](<../../../Verilog%20Source%20code/quartus_word_ram.sv#L1>)

Compute/control không instantiate vendor primitive. Client chỉ truy cập qua pipelined_word_ram; địa chỉ phải nhỏ hơn ROWS.

### [Dòng 16–29: Memory configuration](<../../../Verilog%20Source%20code/quartus_word_ram.sv#L16>)

Port A write và port B read. Address/read control B chốt CLOCK0; output unregistered giữ raw latency một cạnh. M10K không dùng DSP hay PLL.

### [Dòng 30–39: Clock and port binding](<../../../Verilog%20Source%20code/quartus_word_ram.sv#L30>)

Clock enables bypass và các cổng không dùng tie constant. Reset/cancellation thuộc adapter ngoài; memory không có reset.
