nguyennhutkhanhtom/NPU/docs/source_guide/blocks/regfile.sv.md

# regfile.sv — Wrapper SRAM 8 KiB

> **Category: GUIDE. Scope: LEGACY.** RTL is authoritative; diagrams use the [shared visual style](../../diagrams/diagram_style.md).
[Tài liệu](../../README.md) → [Hierarchy RTL](<../legacy/README.md>) → [Mục lục từng file](README.md)

**Trạng thái:** Đang dùng.

**Source:** [regfile.sv](<../../../Verilog%20Source%20code/regfile.sv>).

## At a glance

| Item | Description |
|---|---|
| Responsibility | File này giữ interface riêng cho workspace nhưng dùng chung `sram_256_wrapper` với ADDR_W=8. Module có tên `register`; register ở đây là workspace SRAM, không phải một bank 8 thanh ghi vector như tên lịch sử dễ gợi ra. |

## Sơ đồ kiến trúc tổng quan

```mermaid
%%{init: {
  "theme": "base",
  "themeVariables": {
    "background": "#ffffff",
    "primaryTextColor": "#111111",
    "secondaryTextColor": "#111111",
    "tertiaryTextColor": "#111111",
    "lineColor": "#444444",
    "clusterBkg": "#ffffff",
    "clusterBorder": "#aaaaaa",
    "edgeLabelBackground": "#ffffff",
    "fontSize": "17px"
  },
  "flowchart": {
    "curve": "linear",
    "nodeSpacing": 30,
    "rankSpacing": 40,
    "htmlLabels": true,
    "useMaxWidth": true
  }
}}%%
flowchart TB
C["Compute workspace port<br/>Data 256 bit · address 8 bit"]
    H["Host/debug port<br/>Data 32 bit · word-index 11 bit"]
    subgraph WRAP["regfile.sv — module register"]
        subgraph SRAM["sram_256_wrapper · ADDR_W=8"]
            PORT["Masked write / shared synchronous read<br/>Host lane select + host_rvalid"]
            MEM@{ shape: rect, label: "Workspace memory array 256 ×<br/>256 bit 8 bank ×<br/>32 bit 8 KiB" }
            PORT <--> MEM
        end
    end
    C <-->|"Read/write + valid"| PORT
    H <-->|"32-bit lane access + host_rvalid"| PORT
classDef control fill:#f8cecc,stroke:#b85450,color:#111111;
classDef interface fill:#fff2cc,stroke:#d6b656,color:#111111;
classDef buffer fill:#f5f5f5,stroke:#666666,color:#111111;
classDef compute fill:#b1ddf0,stroke:#10739e,color:#111111;
classDef output fill:#dae8fc,stroke:#6c8ebf,color:#111111;
classDef platform fill:#e1d5e7,stroke:#9673a6,color:#111111;
class C,H,PORT interface;
class MEM buffer;
style SRAM fill:#ffffff,stroke:#aaaaaa,color:#111111;
style WRAP fill:#ffffff,stroke:#aaaaaa,color:#111111;
```

## Main flow

Compute đọc/ghi word 256; host chọn một slice32. Wrapper không thêm FSM hay đổi latency. Mỗi port được nối một-một vào implementation chung; xem sram_256_wrapper để hiểu timing và write mask.

1. Đây là wrapper workspace; tên module `register` được giữ để tương thích và không phải register file pipeline của thesis.
2. Compute address 8 bit chọn 256 word 256 bit. Host address thêm ba bit để chọn tám lane 32 bit.
3. Port được nối thẳng vào `sram_256_wrapper`; wrapper không thêm storage, latency hoặc arbitration.
4. Timing read, mask write và quy tắc không overlap do implementation chung quyết định.

**Quy ước RTL.** Wrapper nối `host_rvalid` từ SRAM lên top. Backend nhận read/address từ frontend và trả host_rvalid sau hai cạnh lên. Frontend top chốt request/response, nên host ngoài giữ read/address bốn cạnh lên đến host_ready. Memory có tám bank 32 bit, write-enable riêng từng lane. Wrapper chỉ nối cổng, không thêm register hoặc đổi latency. Simulation và synthesis dùng cùng hợp đồng memory. Xem [implementation và sơ đồ SRAM](sram_256_wrapper.sv.md).

## Important state / datapath groups

### [Dòng 1–21: Hai giao diện](<../../../Verilog%20Source%20code/regfile.sv#L1>)

**Mục đích.** Địa chỉ compute đếm word 256, host đếm word 32. Host address byte đã được top bỏ hai bit alignment.

**Cách phần code hoạt động.** Nhóm này định nghĩa giao diện, độ rộng, kiểu hoặc tín hiệu trung gian. Nó tạo cấu trúc để các nhóm xử lý sau sử dụng, chưa tự biểu diễn một bước runtime riêng.

**Tín hiệu và dữ liệu chính.** `rd_en`: request đọc của compute; `rd_addr`: địa chỉ word cần đọc; `rd_data`: word dữ liệu đọc ra; `rd_valid`: response đọc hợp lệ; `wr_en`: cho phép ghi compute; `wr_addr`: địa chỉ word cần ghi; và 6 tín hiệu phụ khác trong đoạn code.

### [Dòng 22–40: Instance SRAM](<../../../Verilog%20Source%20code/regfile.sv#L22>)

**Mục đích.** Parameter ADDR_W quyết định depth; các named port nối trực tiếp cùng chức năng.

**Cách phần code hoạt động.** Có instance module con; named-port ở nhóm này xác định chính xác đường control/data giữa hai cấp hierarchy.

**Tín hiệu và dữ liệu chính.** `rd_en`: request đọc của compute; `rd_addr`: địa chỉ word cần đọc; `rd_data`: word dữ liệu đọc ra; `rd_valid`: response đọc hợp lệ; `wr_en`: cho phép ghi compute; `wr_addr`: địa chỉ word cần ghi; và 6 tín hiệu phụ khác trong đoạn code.
