nguyennhutkhanhtom/NPU/docs/source_guide/blocks/sigmoid_lut.svh.md

# sigmoid_lut.svh — Sigmoid U16/F15: 1/(1+exp(-index/16+8))

> **Category: GUIDE. Scope: CURRENT (may also have legacy callers).** RTL is authoritative; diagrams use the [shared visual style](../../diagrams/diagram_style.md).
[Source guide](../README.md) · [Mục lục](README.md)

**Source:** [sigmoid_lut.svh](<../../../Verilog%20Source%20code/sigmoid_lut.svh>).

Independent Decimal reference constructs and verifies every sigmoid entry: [reference.py](../../../tests/reference.py).
