nguyennhutkhanhtom/NPU/docs/source_guide/blocks/sram_word_tile.sv.md

# sram_word_tile.sv

> **Category: GUIDE. Scope: CURRENT (may also have legacy callers).** RTL is authoritative; diagrams use the [shared visual style](../../diagrams/diagram_style.md).
[Documentation](../../README.md) → [Source guide](../full_graph.md) → [RTL index](README.md)

**Source:** [sram_word_tile.sv](<../../../Verilog%20Source%20code/sram_word_tile.sv>).

## At a glance

| Item | Description |
|---|---|
| Responsibility | Replaceable portable SRAM behavior leaf with one synchronous read and one write. Nonblocking assignments preserve old data for same-edge same-address read/write. Storage and read payload have no reset or initialization. |

## Sơ đồ kiến trúc

```mermaid
%%{init: {
  "theme": "base",
  "themeVariables": {
    "background": "#ffffff",
    "primaryTextColor": "#111111",
    "secondaryTextColor": "#111111",
    "tertiaryTextColor": "#111111",
    "lineColor": "#444444",
    "clusterBkg": "#ffffff",
    "clusterBorder": "#aaaaaa",
    "edgeLabelBackground": "#ffffff",
    "fontSize": "17px"
  },
  "flowchart": {
    "curve": "linear",
    "nodeSpacing": 30,
    "rankSpacing": 40,
    "htmlLabels": true,
    "useMaxWidth": true
  }
}}%%
flowchart LR
 W["wr_en / wr_addr / wr_data"] --> M["WIDTH x ROWS memory array<br/>No reset or initialization"]
 R["rd_en / rd_addr"] --> M
 M --> Q["Registered rd_data<br/>Same-edge collision: old data"]
classDef control fill:#f8cecc,stroke:#b85450,color:#111111;
classDef interface fill:#fff2cc,stroke:#d6b656,color:#111111;
classDef buffer fill:#f5f5f5,stroke:#666666,color:#111111;
classDef compute fill:#b1ddf0,stroke:#10739e,color:#111111;
classDef output fill:#dae8fc,stroke:#6c8ebf,color:#111111;
classDef platform fill:#e1d5e7,stroke:#9673a6,color:#111111;
class M,Q buffer;
class W,R compute;
```
