nguyennhutkhanhtom/NPU/docs/source_guide/blocks/ternary_dot32.sv.md

# ternary_dot32.sv

> **Category: GUIDE. Scope: CURRENT (may also have legacy callers).** RTL is authoritative; diagrams use the [shared visual style](../../diagrams/diagram_style.md).
[Documentation](../../README.md) → [Source guide](../full_graph.md) → [RTL index](README.md)

**Source:** [ternary_dot32.sv](<../../../Verilog%20Source%20code/ternary_dot32.sv>).

## At a glance

| Item | Description |
|---|---|
| Responsibility | Thirty-two signed S24 operands multiply ternary codes through S25 sign extension, zero selection and negation. Code 10 produces an aligned reserved flag. Four registered stages implement S25 terms, S28 octets, S29 halves and S30 sum; intervening pair/quad adders are combinational. Throughput is one transaction per cycle. |

## Sơ đồ kiến trúc

```mermaid
%%{init: {
  "theme": "base",
  "themeVariables": {
    "background": "#ffffff",
    "primaryTextColor": "#111111",
    "secondaryTextColor": "#111111",
    "tertiaryTextColor": "#111111",
    "lineColor": "#444444",
    "clusterBkg": "#ffffff",
    "clusterBorder": "#aaaaaa",
    "edgeLabelBackground": "#ffffff",
    "fontSize": "17px"
  },
  "flowchart": {
    "curve": "linear",
    "nodeSpacing": 30,
    "rankSpacing": 40,
    "htmlLabels": true,
    "useMaxWidth": true
  }
}}%%
flowchart TB
 X["32 S24 operands"] --> E["S25 sign extension"]
 W["32 U2 codes<br/>01 plus / 11 minus / 00 zero"] --> T["Registered S25 terms"]
 E --> T
 T --> P["Combinational S26 pairs<br/>Combinational S27 quads"]
 P --> O["Registered S28 octets"]
 O --> H["Registered S29 halves"]
 H --> S["Registered S30 sum_o"]
 W --> F["Code 10 detector<br/>Four-stage reserved / valid pipeline"]
 F --> V["valid_o / reserved_o"]
classDef control fill:#f8cecc,stroke:#b85450,color:#111111;
classDef interface fill:#fff2cc,stroke:#d6b656,color:#111111;
classDef buffer fill:#f5f5f5,stroke:#666666,color:#111111;
classDef compute fill:#b1ddf0,stroke:#10739e,color:#111111;
classDef output fill:#dae8fc,stroke:#6c8ebf,color:#111111;
classDef platform fill:#e1d5e7,stroke:#9673a6,color:#111111;
class X,E,W,T,P,O,H,S,F,V buffer;
```
