nguyennhutkhanhtom/NPU/tests/full_rtl/generated_text.md

# RTL-generated continuation

Prompt: Once upon a time, Lily found a tiny kitten.

 It was going to find the grass and began to have a good friends. 

They wanted to play with a new friend. They played with the park and the slide. Lily was so excited to give her toys and Ben and the park. The dog was very happy. The boy was very happy and she wanted to play with their family. 

Lily was very happy and said, "I have to be careful, but I'm sorry, but I'll be mom,"
