nguyennhutkhanhtom/NPU/docs/verification/npu100_b1_baseline/ARCH_RESEARCH.md

# Architecture research

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

The authority order is RTL and Git diffs, source-matched evidence manifests,
raw reports, then explanatory documents. Historical results apply to their
archived inputs. The latest full-top fit is the local **`npu100_a3`** candidate,
which includes the implemented parameter-memory tiling change on top of this
Git baseline. Its evidence and the earlier `fullrtl100_cache2` archive are
**untracked at review time**. Neither is evidence already in the baseline
commit. Older status documents may describe completed runs as pending.

**Decision:** the latest candidate reaches **91.15 MHz**, with worst setup
**−0.971 ns** at the unchanged 10 ns clock. The 100 MHz target remains unmet.
The next work must address scalar-result distribution, prompt-token selection,
SIMD rounding control and scalar-return control. Section 18 gives the detailed
implementation and verification plan. This update analyzes existing evidence;
it does not implement those proposed RTL changes or launch another build.

## 1. Current architecture

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

Sources: [full graph and formats](docs/design/full_rtl_language.md),
[ASIC portability](docs/design/asic_portability.md),
[SRAM binding](docs/design/asic_memory_binding.md), [rules](AGENTS.md).

## 2. Module hierarchy

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

```text
llm_soc
├── u_reset: reset_release                  two ordinary release FFs
├── u_parameters: llm_parameter_ram         8 lanes, each 32 × 24576 bits
│   └── g_ram_lane[0..7].u_storage: pipelined_word_ram
│       ├── g_ip_tiled.g_tile[0..23].u_storage: quartus_word_ram → altsyncram
│       └── g_model.g_tile[*].u_tile: sram_word_tile (alternative branch)
├── u_vectors: llm_bank_ram                 32 lanes, each 24 × 96 bits
│   └── g_bank[0..31].u_storage: pipelined_word_ram → selected SRAM branch
├── u_cache: llm_bank_ram                   32 lanes, each 24 × 4096 bits
│   └── g_bank[0..31].u_storage: pipelined_word_ram → selected SRAM branch
├── u_math: llm_math                        32 SIMD lanes
│   └── g_mul_lane[0..31].g_byte[0..3].u_mul: logic_mul (128 instances)
├── u_scalar_lo/u_scalar_mid/u_scalar_hi: logic_mul
├── u_exp_mul: logic_mul
├── u_noise_mul: logic_mul
├── u_root: isqrt_u64                       declared in norm.sv
├── u_div: div                             NUM_W=64, DEN_W=32
├── u_sig: sigmoid
│   ├── u_bit_mul: logic_mul
│   └── u_lookup: sigmoid_sample            constant table module
├── u_exp_hi/u_exp_lo: llm_exp_sample        constant table modules
└── u_gumbel_lookup: llm_gumbel_sample       constant table module
```

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

Legacy hierarchy, summarized separately:

```text
matmul_wrap → matmulfree
  ├── PC, ins_mem, descriptor_file
  ├── register (regfile.sv), mem_mapping → sram_256_wrapper
  ├── rowwise_dispatch → rowwise_op → sigmoid, logic_mul
  ├── norm_dispatch → norm → isqrt_u64, div, logic_mul
  ├── ternary_mul → acc_mul, logic_mul, postscale_finish
  └── scale_compose → div, logic_mul
```

Sources: [source guide](docs/source_guide/README.md),
[llm_math](<Verilog Source code/llm_math.sv>),
[parameter RAM](<Verilog Source code/llm_parameter_ram.sv>),
[bank RAM](<Verilog Source code/llm_bank_ram.sv>),
[legacy scheduler](<Verilog Source code/matmulfree.sv>).

## 3. Datapath widths

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

## 4. Memory architecture

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

Latencies below count the accepting rising edge as edge 1:

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

Sources: [memory binding and inferred-array accounting](docs/design/asic_memory_binding.md),
[word adapter](<Verilog Source code/pipelined_word_ram.sv>),
[actual-memory tests](tests/full_rtl/tb_memory_ip.sv).

## 5. Important FSMs

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

## 6. Architecture at d9ed792 — autonomous language graph

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

## 7. Architecture at a2fa161 — early attention clear

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

Evidence milestones after this implementation:
[`b3d3033`](https://github.com/nguyennhutkhanhtom/NPU/commit/b3d3033cf36cd44d6b3dd6ac749c0bbfdd0f1eff)
archives all seven groups and vendor-free elaboration;
[`b9699a7`](https://github.com/nguyennhutkhanhtom/NPU/commit/b9699a7f18a82f01247867dedcabdb045c463d71)
archives its full attention1 timing failure.
[Attention regression](tests/full_rtl/evidence/attention1_all_units/results.json),
[attention timing](docs/verification/timing/fullrtl100_attention1/manifest.json).

## 8. Architecture at 41eea1a — separate KV payload registers

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

## 9. What changed between versions

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

## 10. Measured timing problems

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

Sources: [fanout2 manifest](docs/verification/timing/fullrtl100_fanout2/manifest.json),
[attention1 manifest](docs/verification/timing/fullrtl100_attention1/manifest.json),
[cache1 manifest](docs/verification/timing/fullrtl100_cache1/manifest.json),
[local cache2 detailed setup](docs/verification/timing/fullrtl100_cache2/slow_1100mv_85c_setup.rpt),
[cache2 recommendations](docs/verification/timing/fullrtl100_cache2/slow_1100mv_85c_recommendations.txt),
[current slow-85°C paths](docs/verification/timing/npu100_a3/slow_1100mv_85c_setup.rpt)
(paths 1, 3, 6 and 29),
[current slow-0°C paths](docs/verification/timing/npu100_a3/slow_1100mv_0c_setup.rpt),
[current recommendations](docs/verification/timing/npu100_a3/slow_1100mv_85c_recommendations.txt).

## 11. Synthesis evidence

### Historical synthesis and functional evidence

[Cache2 synthesis](docs/verification/synthesis/cache2/manifest.json) records
successful analysis/synthesis with zero errors and 12 warnings. Its immutable
capture-time status is `SYNTHESIS_PASS_TIMING_PENDING`; the later local timing
manifest resolves timing independently. The
[map summary](docs/verification/synthesis/cache2/llm_soc.map.summary) reports
47,146 registers, 9,515,648 block-memory bits and zero DSP/PLL/DLL/HSSI use.
Map register count is not fitted register count, and the map summary gives no
ALM utilization.

[Cache1 all-seven regression](tests/full_rtl/evidence/cache1_all_units/results.json)
matches the 34 RTL assets of the ca82b2f/cache2 baseline after CRLF→LF
normalization. It does not cover the later changed memory adapter. It records
PASS for actual Quartus memory, math, RAM, host protocol, selection edges,
operators and full graph. The synthetic graph uses two prompt tokens, selects
three tokens in RTL, executes 16 layers, checks causality and takes 4,229,462
compute clocks with 196,619 host commands. Compile/runtime warnings are zero.
It is a functional synthetic fixture, not a pretrained-model quality result.

[Vendor-free elaboration](docs/verification/portable_elaboration_cache1/results.json)
records `USE_QUARTUS_MEMORY=0`, 24 module design units, 14 unique module names,
zero errors/warnings and no vendor memory library. This is a `run 0`
elaboration check, not an inference run or ASIC implementation.

### Current candidate evidence

[npu100_a3 synthesis](docs/verification/synthesis/npu100_a3/manifest.json)
records analysis/synthesis PASS, 53,740 mapped registers, zero errors and
12 warnings. Its capture-time `SYNTHESIS_PASS_TIMING_PENDING` status is retained;
the separate completed timing manifest records the failure.

[Six-group evidence](tests/full_rtl/evidence/npu100_a2_six/results.json)
matches the RTL used for npu100_a3. Actual-memory tests pass 464 checks over
five geometries, including all tile boundaries, sustained read/write collisions
and a partial final tile/group. Math passes 503 transactions, RAM 28 checks,
protocol 29 transactions with 12 cancellations, selection 14 checks, and
operators 17 cases with 3,460 checks, including 128 scalar and 128 clamp cases.
The completed six groups have zero compile/runtime warnings.

[Stopped graph evidence](tests/full_rtl/evidence/npu100_a2_stopped/results.json)
records cancellation when the first frequency result became available. Its
last progress marker is 500,000 clocks, position 0, generated 0; this is not a
completion result or the exact cancellation clock. No current full-graph PASS
exists. The newly prepared portable-elaboration and additional host-cancellation
scripts were not executed. The older PASS must not be substituted for them.

### Full-top fitted comparisons

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

### Latest local all-corner timing: npu100_a3

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

Sources: [current manifest](docs/verification/timing/npu100_a3/manifest.json),
[current fit summary](docs/verification/timing/npu100_a3/llm_soc.fit.summary),
[current unconstrained report](docs/verification/timing/npu100_a3/extracted_unconstrained.rpt),
[stop and audit record](docs/verification/timing/npu100_a3/decision_summary.json),
[timing history](docs/verification/timing/README.md).

## 12. Candidate timing optimizations

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

## 13. Functional invariants that must not change

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

## 14. Architecture at ca82b2f — baseline backend routing correction

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

## 15. Additional real commit milestones

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

## 16. Evidence provenance and reproduction

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

The [source archive record](docs/verification/timing/npu100_a3/source_archive.json)
identifies the immutable ZIP with SHA-256
`e403ab53fa4647ba3a41883be00e1af5375892d428170a9c8800d880d8f93683`.
Use this snapshot with the six-group and cancelled-graph records for the
current candidate. Matching source evidence remains applicable across
documentation-only edits; matching a Git subject alone is insufficient.

Useful read-only Git comparisons, without checking out or reverting history:

```powershell
git show d9ed792:'Verilog Source code/llm_soc.sv'
git show d9ed792:'Verilog Source code/llm_math.sv'
git diff d9ed792 a2fa161 -- 'Verilog Source code' quartus/llm_soc.qsf
git show a2fa161 -- 'Verilog Source code/llm_soc.sv'
git show 41eea1a -- 'Verilog Source code/llm_soc.sv' quartus/llm_soc.qsf
git diff 70c794d ca82b2f -- 'Verilog Source code' quartus/llm_soc.qsf
```

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

## 17. Remaining research questions

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

## 18. Detailed plan to reach 100 MHz from npu100_a3

### 18.1 Scope, target and experiment order

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

### 18.2 P1 — pipeline scalar completion and local distribution

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

Implementation details and correctness obligations:

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

### 18.3 P2 — register prompt addressing and token commit

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

There are exactly three request events, with the original priority and guards:

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

### 18.4 P3 — isolate lane owners and prepare local round commands

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

### 18.5 P4 — give scalar-return state its own register owner

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

| Actual writer | Held return value |
|---|---|
| `L_COEFF` | `L_ROUND` |
| `A_SCALE` | `A_SCORE` |
| `H_COEFF` | `H_ROUND` |

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

### 18.6 Latency, throughput and implementation boundaries

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

### 18.7 Verification and evidence sequence for a later implementation

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

### 18.8 Closure criteria and contingencies

**100 MHz closure requires all conditions below together:**

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
