nguyennhutkhanhtom/NPU/docs/verification/timing/phase1b_head_stream_20261025/slow_1100mv_85c_recommendations_Long Combinational Path.html

## Overview

The Description and Recommendations section gives general advice and recommendations for addressing Long Combinational Path.

The Aggregate Results section shows the Entity Name and the number of occurences of the Entity Name in the identified paths. You can sort the table by clicking the column header.

The Top Recommendations section lists recommendations for the most serious issues identified by the analysis. The number of stars indicates the relative importance of each recommendation, with five stars identifying the most important recommendations. Click show details for more information about each recommendation; click report timing to generate a timing report for the listed path.

The Detailed Results section contains the detailed report for this analysis. Click on show details for more information related to the recommendation for each path; click on report timing to generate a timing report for the listed path. You can sort the table by clicking the column header.

## Description and Recommendations

Each path listed may contain too many levels of combinational logic between the source and destination registers. Even when placed and routed using near optimal resources its timing constraint would be difficult to meet. There may be a solution where this path meets timing, however it will be difficult to find. If many failing paths exist it is unlikely they could all be placed and routed and meet timing.

The following suggestions may help resolve this issue:

- Restructure the appropriate HDL code to reduce the number of combinational logic levels
- Turn on Physical Synthesis for combinational logic or for register retiming
- If only a few paths are failing use a different seed or try running Design Space Explorer
- Set the synthesis Optimization Technique option to Speed in the settings dialog box

See the Top Recommendations section for potential solutions for each path.

## Aggregate Results

| Entity Name | Paths Affected
1 | |llm_soc | 7
2 | |llm_soc|llm_bank_ram:u_cache | 1

## Top Recommendations

★★★

Reduce the levels of combinational logic for the path from llm_bank_ram:u_ca...p.response_q[18]llm_bank_ram:u_cache|pipelined_word_ram:g_bank[14].u_storage|g_ip.response_q[18] to math_b_q[14][18]

- Issue: Long Combinational Path
- From: llm_bank_ram:u_cache|pipelined_word_ram:g_bank[14].u_storage|g_ip.response_q[18]
- To: math_b_q[14][18]
- Timing Analysis: report timing
- Extra levels of combinational logic:
  - 1

★★

Reduce the levels of combinational logic for the path from vector_q[378] to input_cache_q[11][378]

- Issue: Long Combinational Path
- From: vector_q[378]
- To: input_cache_q[11][378]
- Timing Analysis: report timing
- Extra levels of combinational logic:
  - 2

★★

Reduce the levels of combinational logic for the path from vector_q[562] to input_cache_q[10][562]

- Issue: Long Combinational Path
- From: vector_q[562]
- To: input_cache_q[10][562]
- Timing Analysis: report timing
- Extra levels of combinational logic:
  - 1

★★

Reduce the levels of combinational logic for the path from vector_q[213]~DUPLICATE to input_cache_q[9][213]

- Issue: Long Combinational Path
- From: vector_q[213]~DUPLICATE
- To: input_cache_q[9][213]
- Timing Analysis: report timing
- Extra levels of combinational logic:
  - 2

★★

Reduce the levels of combinational logic for the path from vector_q[213]~DUPLICATE to input_cache_q[8][213]

- Issue: Long Combinational Path
- From: vector_q[213]~DUPLICATE
- To: input_cache_q[8][213]
- Timing Analysis: report timing
- Extra levels of combinational logic:
  - 2

★★

Reduce the levels of combinational logic for the path from vector_q[213]~DUPLICATE to input_cache_q[11][213]

- Issue: Long Combinational Path
- From: vector_q[213]~DUPLICATE
- To: input_cache_q[11][213]
- Timing Analysis: report timing
- Extra levels of combinational logic:
  - 2

★★

Reduce the levels of combinational logic for the path from vector_q[289] to input_cache_q[3][289]

- Issue: Long Combinational Path
- From: vector_q[289]
- To: input_cache_q[3][289]
- Timing Analysis: report timing
- Extra levels of combinational logic:
  - 2

## Detailed Results

| Commands | From | To | Importance | Extra levels of combinational logic
1 | report timing | llm_bank_ram:u_ca...p.response_q[18]llm_bank_ram:u_cache|pipelined_word_ram:g_bank[14].u_storage|g_ip.response_q[18] | math_b_q[14][18] | ★★★ | 1
2 | report timing | vector_q[378] | input_cache_q[11][378] | ★★ | 2
3 | report timing | vector_q[562] | input_cache_q[10][562] | ★★ | 1
4 | report timing | vector_q[213]~DUPLICATE | input_cache_q[9][213] | ★★ | 2
5 | report timing | vector_q[213]~DUPLICATE | input_cache_q[8][213] | ★★ | 2
6 | report timing | vector_q[213]~DUPLICATE | input_cache_q[11][213] | ★★ | 2
7 | report timing | vector_q[289] | input_cache_q[3][289] | ★★ | 2
