nguyennhutkhanhtom/NPU/docs/verification/timing/fullrtl100_logic7/fast_1100mv_85c_recommendations_Long Combinational Path.html

## Overview

The Description and Recommendations section gives general advice and recommendations for addressing Long Combinational Path.

The Aggregate Results section shows the Entity Name and the number of occurences of the Entity Name in the identified paths. You can sort the table by clicking the column header.

The Top Recommendations section lists recommendations for the most serious issues identified by the analysis. The number of stars indicates the relative importance of each recommendation, with five stars identifying the most important recommendations. Click show details for more information about each recommendation; click report timing to generate a timing report for the listed path.

The Detailed Results section contains the detailed report for this analysis. Click on show details for more information related to the recommendation for each path; click on report timing to generate a timing report for the listed path. You can sort the table by clicking the column header.

## Description and Recommendations

Each path listed may contain too many levels of combinational logic between the source and destination registers. Even when placed and routed using near optimal resources its timing constraint would be difficult to meet. There may be a solution where this path meets timing, however it will be difficult to find. If many failing paths exist it is unlikely they could all be placed and routed and meet timing.

The following suggestions may help resolve this issue:

- Restructure the appropriate HDL code to reduce the number of combinational logic levels
- Turn on Physical Synthesis for combinational logic or for register retiming
- If only a few paths are failing use a different seed or try running Design Space Explorer
- Set the synthesis Optimization Technique option to Speed in the settings dialog box

See the Top Recommendations section for potential solutions for each path.

## Aggregate Results

| Entity Name | Paths Affected
1 | |llm_soc | 37
2 | |llm_soc|llm_parameter_ram:u_parameters | 5
3 | |llm_soc|llm_bank_ram:u_cache | 4
4 | |llm_soc|llm_bank_ram:u_vectors | 1

## Top Recommendations

★★★

Reduce the levels of combinational logic for the path from rst_n to llm_parameter_ram...a92~porta_we_regllm_parameter_ram:u_parameters|pipelined_word_ram:g_ram_lane[6].u_storage|quartus_word_ram:g_ip.u_storage|altsyncram:u_memory|altsyncram_4a72:auto_generated|ram_block1a92~porta_we_reg

- Issue: Long Combinational Path
- From: rst_n
- To: llm_parameter_ram:u_parameters|pipelined_word_ram:g_ram_lane[6].u_storage|quartus_word_ram:g_ip.u_storage|altsyncram:u_memory|altsyncram_4a72:auto_generated|ram_block1a92~porta_we_reg
- Timing Analysis: report timing
- Extra levels of combinational logic:
  - 1

★★★

Reduce the levels of combinational logic for the path from rst_n to llm_bank_ram:u_ve...1a0~porta_we_regllm_bank_ram:u_vectors|pipelined_word_ram:g_bank[31].u_storage|quartus_word_ram:g_ip.u_storage|altsyncram:u_memory|altsyncram_mt62:auto_generated|ram_block1a0~porta_we_reg

- Issue: Long Combinational Path
- From: rst_n
- To: llm_bank_ram:u_vectors|pipelined_word_ram:g_bank[31].u_storage|quartus_word_ram:g_ip.u_storage|altsyncram:u_memory|altsyncram_mt62:auto_generated|ram_block1a0~porta_we_reg
- Timing Analysis: report timing
- Extra levels of combinational logic:
  - 1

★★★

Reduce the levels of combinational logic for the path from rst_n to llm_bank_ram:u_ca...a12~portb_re_regllm_bank_ram:u_cache|pipelined_word_ram:g_bank[24].u_storage|quartus_word_ram:g_ip.u_storage|altsyncram:u_memory|altsyncram_m672:auto_generated|ram_block1a12~portb_re_reg

- Issue: Long Combinational Path
- From: rst_n
- To: llm_bank_ram:u_cache|pipelined_word_ram:g_bank[24].u_storage|quartus_word_ram:g_ip.u_storage|altsyncram:u_memory|altsyncram_m672:auto_generated|ram_block1a12~portb_re_reg
- Timing Analysis: report timing
- Extra levels of combinational logic:
  - 1

★★★

Reduce the levels of combinational logic for the path from rst_n to llm_bank_ram:u_ca...a11~portb_re_regllm_bank_ram:u_cache|pipelined_word_ram:g_bank[24].u_storage|quartus_word_ram:g_ip.u_storage|altsyncram:u_memory|altsyncram_m672:auto_generated|ram_block1a11~portb_re_reg

- Issue: Long Combinational Path
- From: rst_n
- To: llm_bank_ram:u_cache|pipelined_word_ram:g_bank[24].u_storage|quartus_word_ram:g_ip.u_storage|altsyncram:u_memory|altsyncram_m672:auto_generated|ram_block1a11~portb_re_reg
- Timing Analysis: report timing
- Extra levels of combinational logic:
  - 1

★★★

Reduce the levels of combinational logic for the path from rst_n to llm_parameter_ram...a72~porta_we_regllm_parameter_ram:u_parameters|pipelined_word_ram:g_ram_lane[6].u_storage|quartus_word_ram:g_ip.u_storage|altsyncram:u_memory|altsyncram_4a72:auto_generated|ram_block1a72~porta_we_reg

- Issue: Long Combinational Path
- From: rst_n
- To: llm_parameter_ram:u_parameters|pipelined_word_ram:g_ram_lane[6].u_storage|quartus_word_ram:g_ip.u_storage|altsyncram:u_memory|altsyncram_4a72:auto_generated|ram_block1a72~porta_we_reg
- Timing Analysis: report timing
- Extra levels of combinational logic:
  - 1

★★★

Reduce the levels of combinational logic for the path from rst_n to llm_parameter_ram...a73~porta_we_regllm_parameter_ram:u_parameters|pipelined_word_ram:g_ram_lane[6].u_storage|quartus_word_ram:g_ip.u_storage|altsyncram:u_memory|altsyncram_4a72:auto_generated|ram_block1a73~porta_we_reg

- Issue: Long Combinational Path
- From: rst_n
- To: llm_parameter_ram:u_parameters|pipelined_word_ram:g_ram_lane[6].u_storage|quartus_word_ram:g_ip.u_storage|altsyncram:u_memory|altsyncram_4a72:auto_generated|ram_block1a73~porta_we_reg
- Timing Analysis: report timing
- Extra levels of combinational logic:
  - 1

★★★

Reduce the levels of combinational logic for the path from rst_n to llm_bank_ram:u_ca...1a3~porta_we_regllm_bank_ram:u_cache|pipelined_word_ram:g_bank[27].u_storage|quartus_word_ram:g_ip.u_storage|altsyncram:u_memory|altsyncram_m672:auto_generated|ram_block1a3~porta_we_reg

- Issue: Long Combinational Path
- From: rst_n
- To: llm_bank_ram:u_cache|pipelined_word_ram:g_bank[27].u_storage|quartus_word_ram:g_ip.u_storage|altsyncram:u_memory|altsyncram_m672:auto_generated|ram_block1a3~porta_we_reg
- Timing Analysis: report timing
- Extra levels of combinational logic:
  - 1

★★★

Reduce the levels of combinational logic for the path from rst_n to llm_bank_ram:u_ca...1a4~portb_re_regllm_bank_ram:u_cache|pipelined_word_ram:g_bank[24].u_storage|quartus_word_ram:g_ip.u_storage|altsyncram:u_memory|altsyncram_m672:auto_generated|ram_block1a4~portb_re_reg

- Issue: Long Combinational Path
- From: rst_n
- To: llm_bank_ram:u_cache|pipelined_word_ram:g_bank[24].u_storage|quartus_word_ram:g_ip.u_storage|altsyncram:u_memory|altsyncram_m672:auto_generated|ram_block1a4~portb_re_reg
- Timing Analysis: report timing
- Extra levels of combinational logic:
  - 1

★★★

Reduce the levels of combinational logic for the path from op[88] to lane_round_q[11][0]

- Issue: Long Combinational Path
- From: op[88]
- To: lane_round_q[11][0]
- Timing Analysis: report timing
- Extra levels of combinational logic:
  - 1

★★★

Reduce the levels of combinational logic for the path from op[88] to lane_round_q[11][8]

- Issue: Long Combinational Path
- From: op[88]
- To: lane_round_q[11][8]
- Timing Analysis: report timing
- Extra levels of combinational logic:
  - 1

## Detailed Results

| Commands | From | To | Importance | Extra levels of combinational logic
1 | report timing | rst_n | llm_parameter_ram...a92~porta_we_regllm_parameter_ram:u_parameters|pipelined_word_ram:g_ram_lane[6].u_storage|quartus_word_ram:g_ip.u_storage|altsyncram:u_memory|altsyncram_4a72:auto_generated|ram_block1a92~porta_we_reg | ★★★ | 1
2 | report timing | rst_n | llm_bank_ram:u_ve...1a0~porta_we_regllm_bank_ram:u_vectors|pipelined_word_ram:g_bank[31].u_storage|quartus_word_ram:g_ip.u_storage|altsyncram:u_memory|altsyncram_mt62:auto_generated|ram_block1a0~porta_we_reg | ★★★ | 1
3 | report timing | rst_n | llm_bank_ram:u_ca...a12~portb_re_regllm_bank_ram:u_cache|pipelined_word_ram:g_bank[24].u_storage|quartus_word_ram:g_ip.u_storage|altsyncram:u_memory|altsyncram_m672:auto_generated|ram_block1a12~portb_re_reg | ★★★ | 1
4 | report timing | rst_n | llm_bank_ram:u_ca...a11~portb_re_regllm_bank_ram:u_cache|pipelined_word_ram:g_bank[24].u_storage|quartus_word_ram:g_ip.u_storage|altsyncram:u_memory|altsyncram_m672:auto_generated|ram_block1a11~portb_re_reg | ★★★ | 1
5 | report timing | rst_n | llm_parameter_ram...a72~porta_we_regllm_parameter_ram:u_parameters|pipelined_word_ram:g_ram_lane[6].u_storage|quartus_word_ram:g_ip.u_storage|altsyncram:u_memory|altsyncram_4a72:auto_generated|ram_block1a72~porta_we_reg | ★★★ | 1
6 | report timing | rst_n | llm_parameter_ram...a73~porta_we_regllm_parameter_ram:u_parameters|pipelined_word_ram:g_ram_lane[6].u_storage|quartus_word_ram:g_ip.u_storage|altsyncram:u_memory|altsyncram_4a72:auto_generated|ram_block1a73~porta_we_reg | ★★★ | 1
7 | report timing | rst_n | llm_bank_ram:u_ca...1a3~porta_we_regllm_bank_ram:u_cache|pipelined_word_ram:g_bank[27].u_storage|quartus_word_ram:g_ip.u_storage|altsyncram:u_memory|altsyncram_m672:auto_generated|ram_block1a3~porta_we_reg | ★★★ | 1
8 | report timing | rst_n | llm_bank_ram:u_ca...1a4~portb_re_regllm_bank_ram:u_cache|pipelined_word_ram:g_bank[24].u_storage|quartus_word_ram:g_ip.u_storage|altsyncram:u_memory|altsyncram_m672:auto_generated|ram_block1a4~portb_re_reg | ★★★ | 1
9 | report timing | op[88] | lane_round_q[11][0] | ★★★ | 1
10 | report timing | op[88] | lane_round_q[11][8] | ★★★ | 1
11 | report timing | op[88] | lane_round_q[11][2] | ★★★ | 1
12 | report timing | op[88] | lane_round_q[11][9] | ★★★ | 1
13 | report timing | op[88] | lane_round_q[11][18]~DUPLICATE | ★★★ | 1
14 | report timing | op[88] | lane_round_q[11][18] | ★★★ | 1
15 | report timing | op[88] | lane_round_q[11][19] | ★★★ | 1
16 | report timing | op[88] | lane_round_q[11][17] | ★★★ | 1
17 | report timing | op[88] | lane_round_q[11][16] | ★★★ | 1
18 | report timing | op[88] | lane_round_q[11][5] | ★★★ | 1
19 | report timing | op[88] | lane_round_q[11][4] | ★★★ | 1
20 | report timing | op[88] | lane_round_q[11][6] | ★★★ | 1
21 | report timing | op[88] | lane_round_q[12][33] | ★★★ | 1
22 | report timing | op[88] | lane_round_q[11][10] | ★★★ | 1
23 | report timing | op[88] | lane_round_q[11][11] | ★★★ | 1
24 | report timing | op[88] | lane_round_q[11][7] | ★★★ | 1
25 | report timing | op[88] | lane_round_q[12][38] | ★★★ | 1
26 | report timing | op[88] | lane_round_q[12][31] | ★★★ | 1
27 | report timing | op[88] | lane_round_q[12][44] | ★★★ | 1
28 | report timing | op[88] | lane_round_q[12][46] | ★★★ | 1
29 | report timing | op[88] | lane_round_q[11][27] | ★★★ | 1
30 | report timing | op[88] | lane_round_q[11][26] | ★★★ | 1
31 | report timing | op[88] | lane_round_q[12][45] | ★★★ | 1
32 | report timing | op[88] | lane_round_q[12][42] | ★★★ | 1
33 | report timing | op[88] | lane_round_q[11][28] | ★★★ | 1
34 | report timing | op[88] | lane_round_q[12][41] | ★★★ | 1
35 | report timing | op[88] | lane_round_q[11][24] | ★★★ | 1
36 | report timing | op[88] | lane_round_q[12][43] | ★★★ | 1
37 | report timing | scalar_group_q[2][19] | write_vector_q[211] | ★★ | 1
38 | report timing | llm_parameter_ram...p.response_q[29]llm_parameter_ram:u_parameters|pipelined_word_ram:g_ram_lane[2].u_storage|g_ip.response_q[29] | llm_parameter_ram...rage|rd_data[29]llm_parameter_ram:u_parameters|pipelined_word_ram:g_ram_lane[2].u_storage|rd_data[29] | ★★ | 2
39 | report timing | llm_parameter_ram....write_data_q[2]llm_parameter_ram:u_parameters|g_ram_lane[2].write_data_q[2] | llm_parameter_ram....write_data_q[2]llm_parameter_ram:u_parameters|pipelined_word_ram:g_ram_lane[2].u_storage|g_ip.write_data_q[2] | ★★ | 2
