nguyennhutkhanhtom/NPU/docs/verification/timing/fullrtl100_logic7/slow_1100mv_0c_recommendations_Intradomain Skew.html

## Overview

The Description and Recommendations section gives general advice and recommendations for addressing Intradomain Skew.

The Aggregate Results section shows the Clock Transfer and the number of occurences of the Clock Transfer in the identified paths. You can sort the table by clicking the column header.

The Top Recommendations section lists recommendations for the most serious issues identified by the analysis. The number of stars indicates the relative importance of each recommendation, with five stars identifying the most important recommendations. Click show details for more information about each recommendation; click report timing to generate a timing report for the listed path.

The Detailed Results section contains the detailed report for this analysis. Click on show details for more information related to the recommendation for each path; click on report timing to generate a timing report for the listed path. You can sort the table by clicking the column header.

## Description and Recommendations

Skew between the source register and the destination register makes it difficult for the Quartus Prime Compiler to meet timing constraints for the listed paths.

The following suggestions may help resolve this issue:

- Promoting these clocks to global networks will reduce the internal skew

See the Top Recommendations section for potential solutions for each path.

## Aggregate Results

| Clock Transfer | Paths Affected
1 | clock_0 | 28

## Top Recommendations

★★

Place source and destination clock on the same global clock resource for the path from host_rdata[16]~reg0 to host_rdata[16]

- Issue: Intradomain Skew
- From: host_rdata[16]~reg0
- To: host_rdata[16]
- Timing Analysis: report timing
- Clocks affected:
  - clock_0

★★

Place source and destination clock on the same global clock resource for the path from host_rdata[16]~reg0 to host_rdata[16](n)

- Issue: Intradomain Skew
- From: host_rdata[16]~reg0
- To: host_rdata[16](n)
- Timing Analysis: report timing
- Clocks affected:
  - clock_0

★★

Place source and destination clock on the same global clock resource for the path from host_rdata[17]~reg0 to host_rdata[17]

- Issue: Intradomain Skew
- From: host_rdata[17]~reg0
- To: host_rdata[17]
- Timing Analysis: report timing
- Clocks affected:
  - clock_0

★★

Place source and destination clock on the same global clock resource for the path from host_rdata[17]~reg0 to host_rdata[17](n)

- Issue: Intradomain Skew
- From: host_rdata[17]~reg0
- To: host_rdata[17](n)
- Timing Analysis: report timing
- Clocks affected:
  - clock_0

★★

Place source and destination clock on the same global clock resource for the path from host_rdata[21]~reg0 to host_rdata[21]

- Issue: Intradomain Skew
- From: host_rdata[21]~reg0
- To: host_rdata[21]
- Timing Analysis: report timing
- Clocks affected:
  - clock_0

★★

Place source and destination clock on the same global clock resource for the path from host_rdata[21]~reg0 to host_rdata[21](n)

- Issue: Intradomain Skew
- From: host_rdata[21]~reg0
- To: host_rdata[21](n)
- Timing Analysis: report timing
- Clocks affected:
  - clock_0

★★

Place source and destination clock on the same global clock resource for the path from host_rdata[7]~reg0 to host_rdata[7]

- Issue: Intradomain Skew
- From: host_rdata[7]~reg0
- To: host_rdata[7]
- Timing Analysis: report timing
- Clocks affected:
  - clock_0

★★

Place source and destination clock on the same global clock resource for the path from host_rdata[7]~reg0 to host_rdata[7](n)

- Issue: Intradomain Skew
- From: host_rdata[7]~reg0
- To: host_rdata[7](n)
- Timing Analysis: report timing
- Clocks affected:
  - clock_0

★★

Place source and destination clock on the same global clock resource for the path from host_rdata[23]~reg0 to host_rdata[23]

- Issue: Intradomain Skew
- From: host_rdata[23]~reg0
- To: host_rdata[23]
- Timing Analysis: report timing
- Clocks affected:
  - clock_0

★★

Place source and destination clock on the same global clock resource for the path from host_rdata[23]~reg0 to host_rdata[23](n)

- Issue: Intradomain Skew
- From: host_rdata[23]~reg0
- To: host_rdata[23](n)
- Timing Analysis: report timing
- Clocks affected:
  - clock_0

## Detailed Results

| Commands | From | To | Importance | Clocks affected
1 | report timing | host_rdata[16]~reg0 | host_rdata[16] | ★★ | clock_0
2 | report timing | host_rdata[16]~reg0 | host_rdata[16](n) | ★★ | clock_0
3 | report timing | host_rdata[17]~reg0 | host_rdata[17] | ★★ | clock_0
4 | report timing | host_rdata[17]~reg0 | host_rdata[17](n) | ★★ | clock_0
5 | report timing | host_rdata[21]~reg0 | host_rdata[21] | ★★ | clock_0
6 | report timing | host_rdata[21]~reg0 | host_rdata[21](n) | ★★ | clock_0
7 | report timing | host_rdata[7]~reg0 | host_rdata[7] | ★★ | clock_0
8 | report timing | host_rdata[7]~reg0 | host_rdata[7](n) | ★★ | clock_0
9 | report timing | host_rdata[23]~reg0 | host_rdata[23] | ★★ | clock_0
10 | report timing | host_rdata[23]~reg0 | host_rdata[23](n) | ★★ | clock_0
11 | report timing | host_rdata[2]~reg0 | host_rdata[2] | ★★ | clock_0
12 | report timing | host_rdata[2]~reg0 | host_rdata[2](n) | ★★ | clock_0
13 | report timing | host_rdata[3]~reg0 | host_rdata[3] | ★★ | clock_0
14 | report timing | host_rdata[3]~reg0 | host_rdata[3](n) | ★★ | clock_0
15 | report timing | host_rdata[18]~reg0 | host_rdata[18] | ★★ | clock_0
16 | report timing | host_rdata[18]~reg0 | host_rdata[18](n) | ★★ | clock_0
17 | report timing | host_rdata[22]~reg0 | host_rdata[22] | ★★ | clock_0
18 | report timing | host_rdata[22]~reg0 | host_rdata[22](n) | ★★ | clock_0
19 | report timing | host_rdata[20]~reg0 | host_rdata[20] | ★★ | clock_0
20 | report timing | host_rdata[20]~reg0 | host_rdata[20](n) | ★★ | clock_0
21 | report timing | host_rdata[15]~reg0 | host_rdata[15] | ★★ | clock_0
22 | report timing | host_rdata[15]~reg0 | host_rdata[15](n) | ★★ | clock_0
23 | report timing | host_rdata[13]~reg0 | host_rdata[13] | ★★ | clock_0
24 | report timing | host_rdata[13]~reg0 | host_rdata[13](n) | ★★ | clock_0
25 | report timing | host_rdata[24]~reg0 | host_rdata[24] | ★★ | clock_0
26 | report timing | host_rdata[24]~reg0 | host_rdata[24](n) | ★★ | clock_0
27 | report timing | host_rdata[14]~reg0 | host_rdata[14] | ★★ | clock_0
28 | report timing | host_rdata[14]~reg0 | host_rdata[14](n) | ★★ | clock_0
