nguyennhutkhanhtom/NPU/tests/full_rtl/evidence/arch_final_20261007/rtl/sigmoid.sv

`include "sigmoid_lut.svh"
module sigmoid (
    input logic clk, rst_n, start,
    input logic signed [15:0] x_raw,
    input logic [4:0] frac_bits,
    output logic busy, done,
    output logic [15:0] y_raw
);
    import npu_pkg::*;
    // Generated together with sigmoid_257.mem; default ROM is independent of CWD.
    typedef enum logic [2:0] {IDLE, READ0, READ1, SLOPE, MULTIPLY, ADD, ROUND} state_t;
    state_t state;
    logic [8:0] index_q, index_next;
    logic [23:0] fraction_q, fraction_next;
    logic [15:0] y0, y1;
    logic signed [44:0] grid, x_extended;
    logic [9:0] difference_q;
    logic [33:0] product_q;
    wire [33:0] product_comb;
    logic_mul #(.A_W(24), .B_W(10), .OUT_W(34), .SIGNED_A(0), .SIGNED_B(0)) u_bit_mul
        (.a(fraction_q), .b(difference_q), .product(product_comb));

    logic [16:0] integer_q;
    logic [23:0] remainder_q;
    logic round_up;

    logic [8:0] rom_address;
    logic [15:0] rom_data;

    // A single ROM lookup feeds both sample registers on successive cycles.
    // ASIC synthesis sees a constant case table, never an initialized RAM.
    assign rom_address = (state == READ1 && index_q != 9'h100) ?
    index_q + 9'h001 : index_q;
    sigmoid_sample u_lookup(.index(rom_address), .value(rom_data));
    always_comb begin
        // S16 at F_t=0..24 needs at most 45 signed coordinate bits,
        // including the 128-point offset. Keep all 24 fractional bits.
        x_extended = {{29{x_raw[15]}}, x_raw};
        grid = (x_extended <<< $unsigned(28 - int'(frac_bits))) + (45'sh000_0000_0080 <<< 24);
        if (grid <= 0) begin
            index_next = 0;
            fraction_next = 0;
        end
        else if (grid >= (45'sh000_0000_0100 <<< 24)) begin
            index_next = 9'h100;
            fraction_next = 0;
        end
        else begin
            index_next = grid[32:24];
            fraction_next = grid[23:0];
        end
        // Adjacent samples in the fixed LUT differ by at most 512.
        // Ten unsigned bits retain the exact slope, including the peak step.
    end
    // Registered logic-tree operands/product; rounding uses the parity of the whole
    // interpolated integer, not only the fractional increment.
    assign round_up = remainder_q > 24'h800000 ||
        (remainder_q == 24'h800000 && integer_q[0]);
    always_ff @(posedge clk) begin
        if (rst_n) begin
            if (state == IDLE && start) fraction_q <= fraction_next;
            if (state == READ0) y0 <= rom_data;
            if (state == READ1) y1 <= rom_data;
            if (state == SLOPE) difference_q <= 10'(y1 - y0);
            if (state == MULTIPLY) product_q <= product_comb;
            if (state == ADD) begin
                integer_q <= {1'b0, y0} + {7'h0, product_q[33:24]};
                remainder_q <= product_q[23:0];
            end
        end
    end
    always_ff @(posedge clk or negedge rst_n) begin
        if (!rst_n) begin
            state <= IDLE;
            busy <= 0;
            done <= 0;
            y_raw <= 0;
            index_q <= 0;
        end else begin
            done <= 0;
            case (state)
                IDLE : if (start) begin
                    busy <= 1;
                    index_q <= index_next;
                    state <= READ0;
                end
                READ0 : begin
                    state <= READ1;
                end
                READ1 : begin
                    state <= SLOPE;
                end
                SLOPE : state <= MULTIPLY;
                MULTIPLY : state <= ADD;
                ADD : state <= ROUND;
                ROUND : begin
                    y_raw <= 16'(integer_q + {16'h0, round_up});
                    busy <= 0;
                    done <= 1;
                    state <= IDLE;
                end
                default : state <= IDLE;
            endcase
        end
    end
endmodule
