nguyennhutkhanhtom/NPU/tests/full_rtl/evidence/arch_final_20261007/tests/check_gate.py

"""Reject application execution unless the exact full graph closes at 100 MHz."""
from pathlib import Path
from hashlib import sha256
import argparse
import json

ROOT = Path(__file__).resolve().parents[2]
RTL = ROOT / "Verilog Source code"


def check_gate(manifest_path: Path) -> dict:
    evidence = json.loads(manifest_path.read_text(encoding="utf-8-sig"))
    assert evidence["source_hashes_verified"] and evidence["configuration_hashes_verified"]
    # Metrics are accepted only with the exact archived reports that produced
    # them. A successful tool exit or edited summary is insufficient evidence.
    for collection in ("archives", "text_reports"):
        for name, item in evidence[collection].items():
            path = (manifest_path.parent / name).resolve()
            assert path.is_relative_to(manifest_path.parent.resolve())
            assert sha256(path.read_bytes()).hexdigest() == item["archive_sha256"], \
                f"Timing report changed: {name}"
    assert sha256((manifest_path.parent / "commands.json").read_bytes()).hexdigest() == evidence["commands_sha256"]
    assert evidence["settings"]["TOP_LEVEL_ENTITY"] == "llm_soc", "Timing must cover the full graph top"
    actual = {p.name: sha256(p.read_bytes()).hexdigest() for p in RTL.iterdir()
              if p.suffix in {".sv", ".v", ".svh", ".mem"}}
    assert actual == evidence["rtl_sources"], "RTL changed after timing analysis"
    for name, digest in evidence["configuration"].items():
        path = ROOT / "quartus" / name
        assert sha256(path.read_bytes().replace(b"\r\n", b"\n")).hexdigest() == digest, \
            f"Configuration changed after timing: {name}; final timing must use quartus/llm_soc"
    metrics = evidence["metrics"]
    # The user's FPGA technology policy permits memory IP and ordinary cells,
    # not DSP/PLL hard macros. Check the actual fitted resource report.
    fit_path = manifest_path.parent / "llm_soc.fit.summary"
    assert sha256(fit_path.read_bytes()).hexdigest() == evidence["archives"][fit_path.name]["archive_sha256"], \
        "Fitted resource report changed since timing evidence"
    fit_summary = fit_path.read_text()
    import re
    for resource in ("DSP Blocks", "PLLs", "DLLs", "HSSI RX PCSs",
                     "HSSI PMA RX Deserializers", "HSSI TX PCSs", "HSSI PMA TX Serializers"):
        count = re.search(r"^Total " + resource + r"\s*:\s*(\d+)", fit_summary, re.MULTILINE)
        assert count and int(count[1]) == 0, f"Disallowed fitted {resource}"
    assert metrics["worst_restricted_fmax_mhz"] >= 100, "Fmax is below 100 MHz"
    assert len(metrics["corners"]) == 4
    for corner, item in metrics["corners"].items():
        assert set(item["clocks"]) == {"clk"}
        for kind in ("setup", "hold", "recovery", "removal", "pulse"):
            result = item["clocks"]["clk"][kind]
            assert result["slack_ns"] >= 0 and result["tns_ns"] == 0, f"{corner} {kind} failed"
    for values in metrics["unconstrained"].values():
        assert values["setup"] == 0 and values["hold"] == 0, "Unconstrained paths exist"
    for stage in ("map", "fit", "sta"):
        assert metrics["stage_counts"][stage]["errors"] == 0
        for diagnostic in metrics["stage_counts"][stage]["reported_diagnostics"]:
            assert diagnostic["kind"] != "Error"
            assert diagnostic["id"] != 332148, "Timing requirements were not met"
    units = json.loads((Path(__file__).parent / "unit_results.json").read_text(encoding="utf-8-sig"))
    assert units["status"] == "PASS" and units["rtl_sources"] == actual, "Current operator units have not passed"
    assert set(units["tests"]) == {"tb_quartus_memory", "tb_llm_math", "tb_llm_operators", "tb_llm_protocol", "tb_llm_ram", "tb_llm_graph", "tb_llm_selection"}, \
        "The selection boundary regression must pass along with all existing groups"
    tests = {p.name: sha256(p.read_bytes()).hexdigest() for p in Path(__file__).parent.iterdir()
             if p.name.startswith("tb_") and p.suffix == ".sv" or p.name == "run_units.ps1"}
    assert units["test_sources"] == tests, "Unit tests changed since the recorded run"
    for name, digest in units.get("runner_sources", {}).items():
        path = ROOT / name
        assert sha256(path.read_bytes()).hexdigest() == digest, "Compiled unit runner changed since recorded run"
    for item in units.get("evidence", {}).values():
        path = (ROOT / item["log"]).resolve()
        assert path.is_relative_to(ROOT) and sha256(path.read_bytes()).hexdigest() == item["sha256"], \
            "Unit evidence log changed since recorded run"
        if "design_units" in item:
            binding = item["design_units"]
            path = (ROOT / binding["file"]).resolve()
            assert path.is_relative_to(ROOT) and sha256(path.read_bytes()).hexdigest() == binding["sha256"], \
                "Unit elaboration evidence changed"
    return evidence


if __name__ == "__main__":
    parser = argparse.ArgumentParser()
    parser.add_argument("manifest", type=Path)
    args = parser.parse_args()
    checked = check_gate(args.manifest)
    print(f"FULL_RTL_APPLICATION_GATE_PASS: Fmax={checked['metrics']['worst_restricted_fmax_mhz']} MHz")
