nguyennhutkhanhtom/NPU/(commit log)

2026-09-17 fix sigmoid content
    [observed.csv]
2026-09-27 Keep only source folder tracked on GitHub
    [observed.csv, trace-param.txt]
2026-09-30 Integrate current NPU RTL and publish architecture documentation
    - Consolidate the descriptor-based NPU architecture into the main source,
    including fixed-point normalization, ternary math, rowwise operations,
    sigmoid ROM, scale composition, and the SRAM wrapper.
    - Remove obsolete RTL backups and the unused legacy sigmoid LUT.
    - Publish architecture notes, RTL explanations, implementation reviews,
    Quartus synthesis reports, and preserved documentation history.
    - Make documentation links and the source-guide validator portable.
    - Keep local test suites, Quartus projects, and build caches ignored.
    Verification: full local regression passed in Simulation, SYNTHESIS,
    and QUARTUS_SYNTHES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
    [PC.sv, acc_mul.sv, descriptor_file.sv, div.sv, ins_mem.sv, matmul_wrap.sv, matmulfree.sv, mem_mapping.sv]
2026-10-01 Integrate isolated M10K backend and verify zero DSP/PLL full-top fit
    Actual Intel RAM model: 158 contract checks PASS; six exact-source unit groups PASS, complete graph pending. Full llm_soc A&S and fitting PASS with 0 DSP and 0 PLL; four-corner timing remains FAIL at 87.49 MHz, so pretrained application stays blocked. Preserve byte-exact timing/test evidence, prior failures, source archives and memory ASIC replacement contracts.
    [application_tb.sv, check_gate.py, llm_bank_ram.sv, llm_parameter_ram.sv, llm_soc.sv, pipelined_word_ram.sv, quartus_word_ram.sv]
2026-10-04 Pipeline portable arithmetic/control and archive six-unit verification; timing remains 92.75MHz FAIL
    [check_gate.py, export_checkpoint.py, finalize_application.py, llm_bank_ram.sv, llm_math.sv, llm_parameter_ram.sv, llm_soc.sv]
2026-10-04 Remove SIMD payload enable fanout and condition reset release with standard FFs
    [llm_math.sv, llm_soc.sv, memory_model.py, reset_release.sv, tb_graph.sv, tb_math.sv]
2026-10-04 Archive exact-source seven-group PASS and release1 all-corner timing failure
    [application_tb.sv, memory_model.py, tb_graph.sv, tb_math.sv, tb_memory_ip.sv, tb_operators.sv, tb_protocol.sv]
2026-10-04 Retire unused native simulation helpers and clarify current portable RTL status
2026-10-04 Record current ASIC RTL policy review and simplify documentation hub
2026-10-04 Verify current attention clear with seven RTL groups and portable full-top elaboration
2026-10-05 docs: refresh guides and source-grounded RTL diagrams
    Reorganize architecture, verification and real-model demo documentation. Update Mermaid diagrams and source excerpts; add editable llm_soc hierarchies for Quartus and portable memory, previews and validation tools.
    Validation: 63 Mermaid diagrams rendered; 9 hierarchy pages checked; 41 RTL/LUT hashes preserved; documentation and hierarchy validators PASS.
2026-10-24 Remove the 25 unreachable op FSM states from llm_soc
    Following every op transition from O_IDLE, including return_* dispatch
    arms only when their label is assigned in a reachable state, reaches 87
    of the 112 declared one-hot states. The other 25 are leftovers from the
    pre-streaming linear, attention and head sequencers (L_WEIGHT..L_STORE,
    A_KEY..A_PACK, H_WEIGHT..H_MAC, L_SAT/A_SAT, L_FLAGS/A_FLAGS, SC_ROUTE,
    L_DECODE, L_DOT_WAIT).
    Remove them, their dispatch arms and the ten return labels that only
    served them. The scalar packet/cluster/clamp/lane-pack registers are now
    enabled by linear_pipe_valid_q[4..7] alone, and scalar_packet_linear_q,
    which only chose between L_SAT and A_SAT, is gone.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
2026-10-24 Record the seven-group evidence for Phase 1A and the dead-state removal
    Run the seven unit/graph groups for main (d53cdd9, the Phase 1A RTL)
    and this branch under Xcelium 23.03 and Questa 2024.1. All 28 runs pass
    with zero errors. Every marker except the operator group's matches
    between baseline and candidate, including graph clocks=570837. The
    operator group drops the attention-only clamp and cancel variants:
    checks 6611 -> 5843, clamp_cases 516 -> 260, scalar_reset_cases 6 -> 3.
    Results, commands, tool versions and per-file source hashes are in
    tests/full_rtl/evidence/dead_states_20261024/results.json.
    TASK_STATE.md and optimization_status.md still described the
    phase1a_linear_20261008 ti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
2026-10-24 Count parameter stalls in the linear stream fixture
    Phase 1A still lacked isolated parameter-stall counts. While rows remain
    to issue, tb_linear_stream now classifies every cycle without an operand
    capture as a missing parameter word (before or after the first capture)
    or a missing result slot, and stops on any other cause. A new
    LINEAR_STREAM_STALLS line reports the counts for every non-fault run.
2026-10-24 Record the fault-drain fix and parameter-stall evidence
    Candidate 9e73944 passes the seven groups and tb_llm_linear_stream
    under Xcelium 23.03 and Questa 2024.1 (16/16, zero errors). The
    restored tb_protocol fault-drain regression fails on main RTL in both
    simulators, which confirms the relaunch race there.
    The linear stream fixture now gives isolated parameter-stall counts:
    one stall per parameter word after the first two, 19-20% of linear
    cycles with the five-cycle parameter response. TASK_STATE.md records
    the running full-top timing job for this RTL.
2026-10-24 Measure clamp saturation and keep overflow_out linear-only
    A read-only bind monitor (tests/full_rtl/clamp_monitor.sv) counts
    saturation at every clamp site of llm_soc. On the merged RTL, the
    pretrained NanoFable export passes application_tb directly under Xcelium
    and Questa: 96/96 tokens equal the reference, 19,958,382 clocks,
    overflow_out=0.
    None of the 1,449,216 activation clamp samples saturates in that run.
    Only the designed exp underflow fires (557 of 90,736 attention
    probabilities). Widening overflow_out would change no observed result,
    so the flag keeps its linear-only scope, now stated in host_interface.md.
2026-10-24 Record 100 MHz timing for the PR #3 RTL and close Phase 1A
    Full-top timing dead_states_fault_drain_20261024 matches main eb4274f
    (41 RTL files, QPF/QSF/SDC). All four corners meet 100 MHz with minimum
    Fmax 100.74 MHz (slow 85 C setup +0.073 ns); hold, recovery, removal
    and pulse slack are nonnegative and no path is unconstrained. Every
    Phase 1A measurement gate now has evidence, so NPU_V2_EXECUTION.md
    records Phase 1A as done and Phase 1B as current (not started).
2026-10-25 Record the gated pretrained-application PASS on the current RTL
    run_units.ps1 -Questa passes all seven groups on local Questa Altera
    Starter 2025.2 with zero errors and warnings; markers equal the server
    runs (graph clocks=570837 host_commands=196619). check_gate.py opens
    the gate against dead_states_fault_drain_20261024 (Fmax 100.74 MHz).
    run_application.ps1 then matches all 96 RTL tokens to the integer
    reference: clocks=19958382 host_commands=196722 overflow=0,
    hardware_gate=PASS. Text quality is not assessed by the runner.
2026-10-25 Stream LM-head rows and close Phase 1B
    llm_head_engine streams all 4,096 vocabulary rows from one start with
    eight read credits and two packed-scale slots; llm_soc replaces nine
    per-row head states with a six-stage epilogue that reuses the scalar
    multiplier. Numerics, PRNG order and host protocol are unchanged.
    Head pass 121,886 -> 16,948 cycles; synthetic graph 570,837 -> 280,599
    clocks; pretrained application 96/96 tokens in 9,884,334 clocks under
    Xcelium and Questa. Seven groups plus both stream fixtures pass on both
    simulators; SpyGlass lint 0 errors, 0 new messages. Full-top timing
    meets 100 MHz at all corners (min Fmax 101.53 MHz).
2026-10-27 Make the source-tree Vietnamese docs the canonical RTL module docs
    The per-module docs in Verilog Source code/doc/ track the current RTL
    (Phase 1B), while docs/source_guide/blocks/*.sv.md was a 2026-10-06
    snapshot whose hashes and excerpts no longer match the source.
    - Add Verilog Source code/doc/README.md: index of all 41 RTL/LUT files
    to their module docs, a current-status summary linked to
    optimization_status.md, and the update rule.
    - Carry over the facts only the old pages had, checked against RTL:
    reset behaviour of llm_head_engine, llm_linear_engine and
    llm_parameter_ram, the llm_parameter_ram parameter table, and how
    sigmoid_257.mem is checked but never loaded.
    - Remove th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
